gusmaoWilliam/FATECSO_PIC_ECU/README.md

# FATEC-Sorocaba-ECU-PIC-Verde
Desenvolvimento do gerenciamento do motor do carro didático VW Polo Flex utilizando um hardware desenvolvido por um grupo de alunos de Eletrônica Automotiva da Fatec Santo André.

Este repositório contém os firmwares atualizados dos PICs, software aplicativo deesenvolvido com o a plataforma QTCreator, e o firmware para arduino de um gerador de sinais de rotação e fase, cujas versoes foram as utilizadas na finalização do TCC "Sistema de aquisição de dados e calibração online aplicados à unidade de gerenciamento de um motor a combustão" apresentado pelos alunos William Miranda Gusmão e Lucas Wallace Martins.
