gusmaoWilliam/FATECSO_PIC_ECU/Hardware Placa Verde PIC/Lista de Componentes/Lista de componentes contidos na placa para a versão nova - Cópia.xls

Lista de Componentes Atualizada para nova versão da placa.
Resistores | Quantidade | Capacitores | Quantidade | Diodos | Quantidade | Transistores | Quantidade | Crystais | Quantidade | Cis | Quantidade | Outros | Quantidade
1M | 5 | 22pf | 10 | 1N4004 | 1 | IRGS14C40L | 4 | 10Mhz | 4 | TPIC8101 | 1 | Led | 21
10k | 76 | 100pf | 11 | 1N5624 | 2 | IRLL014N | 9 | 6Mhz | 1 | LM2596S | 1 | Indutor | 1
470R | 4 | 100uf/16v | 5 | 1N4148 | 20 |  |  | 20Mhz | 1 | AD623 | 2 | Trimpot 5k | 2
100k | 22 | 100nf | 90 |  |  |  |  |  |  | LM358D | 10 | MiniUSB | 1
1K | 31 | 680uF/35v | 1 |  |  |  |  |  |  | LM339 | 3 | Push button | 2
4k7 | 5 | 470uf/25v | 1 |  |  |  |  |  |  | MCP2515 | 1 | Chave Magirus | 1
5k6 | 11 | 1uf | 6 |  |  |  |  |  |  | PCA82C251T/N3 | 1 | Botoes SMD | 4
10R | 1 | 10pf | 2 |  |  |  |  |  |  | FT232RL | 1 | Pinos Torneados | 50
220R | 1 | 4u7f/16 | 1 |  |  |  |  |  |  | MC33186 | 1 | Jumper para Programação | 4
120R | 1 | 47uf/25v | 1 |  |  |  |  |  |  | MC33810 | 1 | Bournes | 4
100R | 2 | 33nf | 1 |  |  |  |  |  |  | LM1815 | 1
0R02 | 1 | 47nf | 1
4k | 4 | 330nf | 1
36k | 4 | 1nf | 1
3k6 | 1
18k | 1
150k | 1
