gusmaoWilliam/FATECSO_PIC_ECU/Hardware Placa Verde PIC/Lista de Componentes/Lista de componentes para 1 placa (v2).xls

Part | Value | Device | Package | Library | Sheet | Imagens dos componentes |  | Quantidade
+5V |  | LEDKA-3528ASYC | KA-3528ASYC | led | 2 |  |  | 21
+12V |  | LEDKA-3528ASYC | KA-3528ASYC | led | 2
BOB1 |  | LEDKA-3528ASYC | KA-3528ASYC | led | 14
BOB2 |  | LEDKA-3528ASYC | KA-3528ASYC | led | 14
TX |  | LEDKA-3528ASYC | KA-3528ASYC | led | 10
TXCAN |  | LEDKA-3528ASYC | KA-3528ASYC | led | 9
RX |  | LEDKA-3528ASYC | KA-3528ASYC | led | 10
RXCAN |  | LEDKA-3528ASYC | KA-3528ASYC | led | 9
IGN1 |  | LEDKA-3528ASYC | KA-3528ASYC | led | 15
IGN2 |  | LEDKA-3528ASYC | KA-3528ASYC | led | 15
IGN3 |  | LEDKA-3528ASYC | KA-3528ASYC | led | 15
IGN4 |  | LEDKA-3528ASYC | KA-3528ASYC | led | 15
INJ1 |  | LEDKA-3528ASYC | KA-3528ASYC | led | 15
INJ2 |  | LEDKA-3528ASYC | KA-3528ASYC | led | 15
INJ3 |  | LEDKA-3528ASYC | KA-3528ASYC | led | 15
INJ4 |  | LEDKA-3528ASYC | KA-3528ASYC | led | 15
LED1 |  | LEDKA-3528ASYC | KA-3528ASYC | led | 1
LED2 |  | LEDKA-3528ASYC | KA-3528ASYC | led | 8
LED3 |  | LEDKA-3528ASYC | KA-3528ASYC | led | 14
LED4 |  | LEDKA-3528ASYC | KA-3528ASYC | led | 17
LED16 |  | LEDKA-3528ASYC | KA-3528ASYC | led | 11
ANTER_IN | PINO_TORNEADO | PINO_TORNEADO | PINO_TORNEADO | MyLibs | 16 |  |  | 45
BORBOLETA_1 | PINO_TORNEADO | PINO_TORNEADO | PINO_TORNEADO | MyLibs | 12
BORBOLETA_2 | PINO_TORNEADO | PINO_TORNEADO | PINO_TORNEADO | MyLibs | 12
COND_ANA2_IN | PINO_TORNEADO | PINO_TORNEADO | PINO_TORNEADO | MyLibs | 6
COND_ANA_1_IN | PINO_TORNEADO | PINO_TORNEADO | PINO_TORNEADO | MyLibs | 6
LINHA15 | PINO_TORNEADO | PINO_TORNEADO | PINO_TORNEADO | MyLibs | 17
LINHA_15_IN | PINO_TORNEADO | PINO_TORNEADO | PINO_TORNEADO | MyLibs | 17
MAP_IN | PINO_TORNEADO | PINO_TORNEADO | PINO_TORNEADO | MyLibs | 16
MAP_OUT | PINO_TORNEADO | PINO_TORNEADO | PINO_TORNEADO | MyLibs | 16
MEDI_VELO_IN | PINO_TORNEADO | PINO_TORNEADO | PINO_TORNEADO | MyLibs | 17
MEDI_VELO_OUT | PINO_TORNEADO | PINO_TORNEADO | PINO_TORNEADO | MyLibs | 17
PEDAL1_IN | PINO_TORNEADO | PINO_TORNEADO | PINO_TORNEADO | MyLibs | 5
PEDAL2_IN | PINO_TORNEADO | PINO_TORNEADO | PINO_TORNEADO | MyLibs | 5
RA0_ADMISS_TPS_1 | PINO_TORNEADO | PINO_TORNEADO | PINO_TORNEADO | MyLibs | 13
RA0_GERENC_BATERIA | PINO_TORNEADO | PINO_TORNEADO | PINO_TORNEADO | MyLibs | 6
RA1_ADMISS_TPS_2 | PINO_TORNEADO | PINO_TORNEADO | PINO_TORNEADO | MyLibs | 13
RA1_GERENC_PEDAL_1 | PINO_TORNEADO | PINO_TORNEADO | PINO_TORNEADO | MyLibs | 5
RA2_ADMISS_ALTERNADOR | PINO_TORNEADO | PINO_TORNEADO | PINO_TORNEADO | MyLibs | 16
RA2_GERENC_PEDAL2 | PINO_TORNEADO | PINO_TORNEADO | PINO_TORNEADO | MyLibs | 5
RB5_GERENC_PRESS絨_A/C | PINO_TORNEADO | PINO_TORNEADO | PINO_TORNEADO | MyLibs | 6
RC7_GERENCIA_EMBREAGEM | PINO_TORNEADO | PINO_TORNEADO | PINO_TORNEADO | MyLibs | 7
RD2_GERENC_FREIO_1 | PINO_TORNEADO | PINO_TORNEADO | PINO_TORNEADO | MyLibs | 17
RD3_GERENCI_COMBUSTIVEL | PINO_TORNEADO | PINO_TORNEADO | PINO_TORNEADO | MyLibs | 7
RD5_GERENC_FREIO_2 | PINO_TORNEADO | PINO_TORNEADO | PINO_TORNEADO | MyLibs | 7
RD6_GERENC_BOTﾃO_A/C | PINO_TORNEADO | PINO_TORNEADO | PINO_TORNEADO | MyLibs | 7
RE2_SINCRO_FASE | PINO_TORNEADO | PINO_TORNEADO | PINO_TORNEADO | MyLibs | 17
RELUTﾂNCIA | PINO_TORNEADO | PINO_TORNEADO | PINO_TORNEADO | MyLibs | 18
ROT_ANAL | PINO_TORNEADO | PINO_TORNEADO | PINO_TORNEADO | MyLibs | 18
ROT_DIG_IN | PINO_TORNEADO | PINO_TORNEADO | PINO_TORNEADO | MyLibs | 18
ROT_DIG_OUT | PINO_TORNEADO | PINO_TORNEADO | PINO_TORNEADO | MyLibs | 18
SENSOR_COMB_IN | PINO_TORNEADO | PINO_TORNEADO | PINO_TORNEADO | MyLibs | 7
SENSOR_FASE_IN | PINO_TORNEADO | PINO_TORNEADO | PINO_TORNEADO | MyLibs | 17
SENSOR_IN | PINO_TORNEADO | PINO_TORNEADO | PINO_TORNEADO | MyLibs | 7
SENSOR_IN1 | PINO_TORNEADO | PINO_TORNEADO | PINO_TORNEADO | MyLibs | 17
SENSO_EMBR_IN | PINO_TORNEADO | PINO_TORNEADO | PINO_TORNEADO | MyLibs | 7
SENSO_FREIO_IN | PINO_TORNEADO | PINO_TORNEADO | PINO_TORNEADO | MyLibs | 7
TEMP_AR_IN | PINO_TORNEADO | PINO_TORNEADO | PINO_TORNEADO | MyLibs | 4
TEMP_AR_OUT | PINO_TORNEADO | PINO_TORNEADO | PINO_TORNEADO | MyLibs | 4
TEMP_H2O_IN | PINO_TORNEADO | PINO_TORNEADO | PINO_TORNEADO | MyLibs | 4
TEMP_H2O_OUT | PINO_TORNEADO | PINO_TORNEADO | PINO_TORNEADO | MyLibs | 4
TPS_1_IN | PINO_TORNEADO | PINO_TORNEADO | PINO_TORNEADO | MyLibs | 13
TPS_2_IN | PINO_TORNEADO | PINO_TORNEADO | PINO_TORNEADO | MyLibs | 13
SV1 |  | MA03-1 | MA03-1 | con-lstb | 1
SV2 |  | MA03-1 | MA03-1 | con-lstb | 14
OP.MODE |  | M251 | M251 | switch | 18
SENSIBILIDADE |  | M251 | M251 | switch | 18
SV3 |  | MA04-2 | MA04-2 | con-lstb | 18
C64 | 100uF/16V | CPOL-EUE2.5-7 | E2,5-7 | rcl | 2 |  |  | 5
C66 | 100uF/16V | CPOL-EUE2.5-7 | E2,5-7 | rcl | 1
C98 | 100uF/16V | CPOL-EUE2.5-7 | E2,5-7 | rcl | 8
C39 | 100uF/16V | CPOL-EUE2.5-7 | E2,5-7 | rcl | 14
C122 | 100uF/16V | CPOL-EUE2.5-7 | E2,5-7 | rcl | 11
C95 | 47uF/25V | CPOL-EUE2.5-7 | E2,5-7 | rcl | 12 |  |  | 1
C63 | 470uf/25V | CPOL-EUE3.5-8 | E3,5-8 | rcl | 2 |  |  | 1
C113 | 680uF/35V | CPOL-EUE3.5-10 | E3,5-10 | rcl | 2 |  |  | 1
C119 | 4u7F/16V | CPOL-EUE2.5-7 | E2,5-7 | rcl | 10 |  |  | 1
C1 | 100nF | C-EUC0805 | C0805 | resistor | 5 |  |  | 90
C2 | 100nF | C-EUC0805 | C0805 | resistor | 5
C3 | 100nF | C-EUC0805 | C0805 | resistor | 5
C4 | 100nF | C-EUC0805 | C0805 | resistor | 5
C5 | 100nF | C-EUC0805 | C0805 | resistor | 16
C6 | 100nF | C-EUC0805 | C0805 | resistor | 16
C7 | 100nF | C-EUC0805 | C0805 | resistor | 16
C8 | 100nF | C-EUC0805 | C0805 | resistor | 16
C9 | 100nF | C-EUC0805 | C0805 | resistor | 5
C10 | 100nF | C-EUC0805 | C0805 | resistor | 5
C11 | 100nF | C-EUC0805 | C0805 | resistor | 5
C12 | 100nF | C-EUC0805 | C0805 | resistor | 5
C13 | 100nF | C-EUC0805 | C0805 | resistor | 4
C14 | 100nF | C-EUC0805 | C0805 | resistor | 4
C15 | 100nF | C-EUC0805 | C0805 | resistor | 4
C16 | 100nF | C-EUC0805 | C0805 | resistor | 4
C17 | 100nF | C-EUC0805 | C0805 | resistor | 4
C18 | 100nF | C-EUC0805 | C0805 | resistor | 4
C19 | 100nF | C-EUC0805 | C0805 | resistor | 4
C20 | 100nF | C-EUC0805 | C0805 | resistor | 4
C25 | 100nF | C-EUC0805 | C0805 | resistor | 13
C26 | 100nF | C-EUC0805 | C0805 | resistor | 13
C27 | 100nF | C-EUC0805 | C0805 | resistor | 13
C28 | 100nF | C-EUC0805 | C0805 | resistor | 13
C29 | 100nF | C-EUC0805 | C0805 | resistor | 13
C30 | 100nF | C-EUC0805 | C0805 | resistor | 13
C31 | 100nF | C-EUC0805 | C0805 | resistor | 13
C32 | 100nF | C-EUC0805 | C0805 | resistor | 13
C36 | 100nF | C-EUC0805 | C0805 | resistor | 18
C37 | 100nF | C-EUC0805 | C0805 | resistor | 18
C40 | 100nF | C-EUC0805 | C0805 | resistor | 12
C41 | 100nF | C-EUC0805 | C0805 | resistor | 15
C42 | 100nF | C-EUC0805 | C0805 | resistor | 17
C43 | 100nF | C-EUC0805 | C0805 | resistor | 17
C44 | 100nF | C-EUC0805 | C0805 | resistor | 7
C45 | 100nF | C-EUC0805 | C0805 | resistor | 7
C46 | 100nF | C-EUC0805 | C0805 | resistor | 15
C47 | 100nF | C-EUC0805 | C0805 | resistor | 15
C48 | 100nF | C-EUC0805 | C0805 | resistor | 15
C49 | 100nF | C-EUC0805 | C0805 | resistor | 15
C50 | 100nF | C-EUC0805 | C0805 | resistor | 15
C54 | 100nF | C-EUC0805 | C0805 | resistor | 7
C55 | 100nF | C-EUC0805 | C0805 | resistor | 7
C56 | 100nF | C-EUC0805 | C0805 | resistor | 7
C57 | 100nF | C-EUC0805 | C0805 | resistor | 17
C58 | 100nF | C-EUC0805 | C0805 | resistor | 7
C59 | 100nF | C-EUC0805 | C0805 | resistor | 7
C60 | 100nF | C-EUC0805 | C0805 | resistor | 7
C61 | 100nF | C-EUC0805 | C0805 | resistor | 17
C62 | 100nF | C-EUC0805 | C0805 | resistor | 15
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
U$17 | IRLL014N | IRLL014N | SOT-223 | MyLibs | 19
U$1 | IRLL014N | IRLL014N | SOT-223 | MyLibs | 19
U$26 | IRLL014N | IRLL014N | SOT-223 | MyLibs | 19
U$27 | IRLL014N | IRLL014N | SOT-223 | MyLibs | 19
U$28 | IRLL014N | IRLL014N | SOT-223 | MyLibs | 19
U$29 | IRLL014N | IRLL014N | SOT-223 | MyLibs | 19
U$30 | IRLL014N | IRLL014N | SOT-223 | MyLibs | 19
U$4 | IRGS14C40L | IRGS14C40L | TO-263AB | MyLibs | 15
U$6 | IRGS14C40L | IRGS14C40L | TO-263AB | MyLibs | 15
U$7 | IRGS14C40L | IRGS14C40L | TO-263AB | MyLibs | 15
U$8 | IRGS14C40L | IRGS14C40L | TO-263AB | MyLibs | 15
S1 | 2P2T | 2P2T | 2P2T | switch | 17
S2 | 2P2T | 2P2T | 2P2T | switch | 16
U$15 | BUTTON | BUTTON | BUTTON_SMD | MyLibs | 8
U$18 | BUTTON | BUTTON | BUTTON_SMD | MyLibs | 1
U$20 | BUTTON | BUTTON | BUTTON_SMD | MyLibs | 11
U$21 | BUTTON | BUTTON | BUTTON_SMD | MyLibs | 14
X2 | MINI-USB-32005-201 | MINI-USB-32005-201 | 32005-201 | con-cypressindustri | es 10
U$5 | MAGIRUS_17105 | MAGIRUS_17105 | MAGIRUS_TICTAC_3_PIN | MyLibs | 2
U$11 | MAGIRUS_17105 | MAGIRUS_17105 | MAGIRUS_TICTAC_3_PIN | MyLibs | 2
L1 | 33uh-5A | L-USWE-TPC | POWER-CHOKE_WE-TPC | rcl | 2
X1 | 1751248 | 1751248 | 1751248 | con-phoenix-350 | 2
X3 | 1727036 | 1727036 | 1727036 | con-phoenix-3.81 | 7 |  | 4 pinos
X4 | 1727036 | 1727036 | 1727036 | con-phoenix-3.81 | 15
IGN_1 | 1727036 | 1727036 | 1727036 | con-phoenix-3.81 | 14
IC8 | LM2596S | LM2596S | TO263-5 | national-semiconduc | tor 2
IC12 | FT232RL | FT232RL | SSOP28 | ftdichip | 10
MC1 | MC33810 | MC33810 | SOIC_32_PIN | MyLibs | 15
PIN | CONCTOR_BOSCH | CONCTOR_BOSCH | V23542-A1280-B300 | MyLibs | 2
U$2 | LM1815 | LM1815 | SOICLM1815 | MyLibs | 18
U$3 | MC33186 | MC33186 | HSOP-20-PIN | MyLibs | 12
U$9 | AD623 | AD623 | SOIC-8 | MyLibs | 3
U$10 | AD623 | AD623 | SOIC-8 | MyLibs | 3
U$19 | JHD162A | JHD162A | JHD162A | MyLibs | 8
U$22 | TPIC8101 | TPIC8101 | SOIC-20P | MyLibs | 2
U$31 | MCP2515-I/SO | MCP2515-I/SO | SOIC127P1034X264-18N | Microchip_By_elemen | t14_Batch_1 9
U$32 | TRIMPOT | TRIMPOT | TRIMPOT | MyLibs | 8
U$33 | HC-06 | HC-06 | FE06 | MyLibs | 10
U1 | LM339 | LM339 | SOIC14N | MyLibs | 17
U2 | LM339 | LM339 | SOIC14N | MyLibs | 7
U3 | LM339 | LM339 | SOIC14N | MyLibs | 17
U20 | PCA82C251T/N3 | PCA82C251T/N3 | SOIC127P600X175-8N | NXP_By_element14_Ba | tch_1 9
SINCRONISMO | PIC18F46K22 | PIC18F46K22 | DIP40 | MyLibs | 14
GERENCIAMENTO | PIC18F46K22 | PIC18F46K22 | DIP40 | MyLibs | 1
ADMISSﾃO | PIC18F46K22 | PIC18F46K22 | DIP40 | MyLibs | 11
COMUNICACAO | PIC18F46K22 | PIC18F46K22 | DIP40 | MyLibs | 8
