gusmaoWilliam/FATECSO_PIC_ECU/Apresentação Aquisiçao e Calibração/Apresentação_Calibração_Aquisição.pptx

## Núcleo de Pesquisa em Powertrain

AQUISIÇÃO DE DADOS E CALIBRAÇÃO ONLINE DA ECU PIC

## Comunicação Assincrona

- BAUDRATE

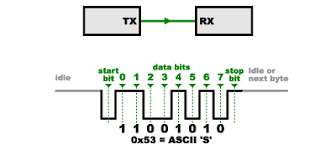
[picture p1: figure]

## Protocolo UART

- UART é o acrônimo de Universal Asynchrounous Receiver/Transmiter ou Receptor/Transmissor Universal Assíncrono.

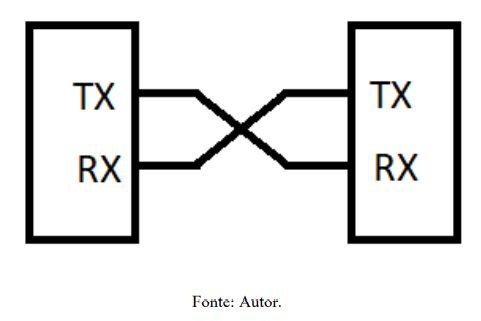
[picture p2: figure]

## Protocolo UART

- FRAME:
- Start bit: S
- Stop bit: T
- Bit de paridade: P
- Dados: 01234567

## Firmware Comunicação

- O PIC responsável pela comunicação tem por objetivo estabelecer o fornecimento de dados para os demais PIC’s, e torna possível o envio para um protocolo de comunicação USB, em que permite se conectar a um computador para que sejam coletados os dados dos sensores pela interface de aquisição e calibração desenvolvida.

## Firmware Comunicação

- Interrupção

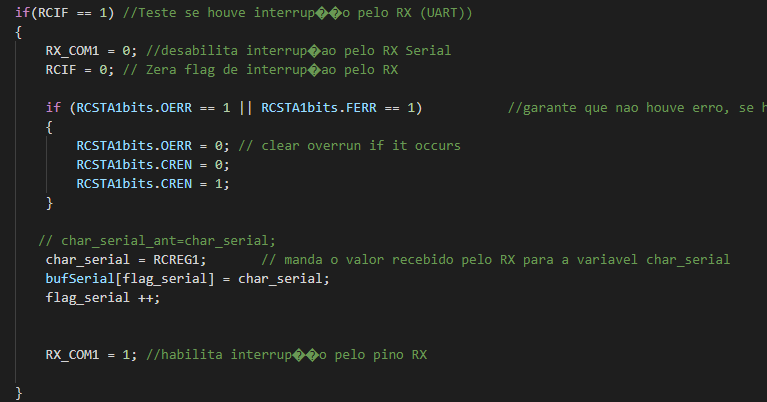
[picture p3: figure]

## Firmware Comunicação

- Interrupção

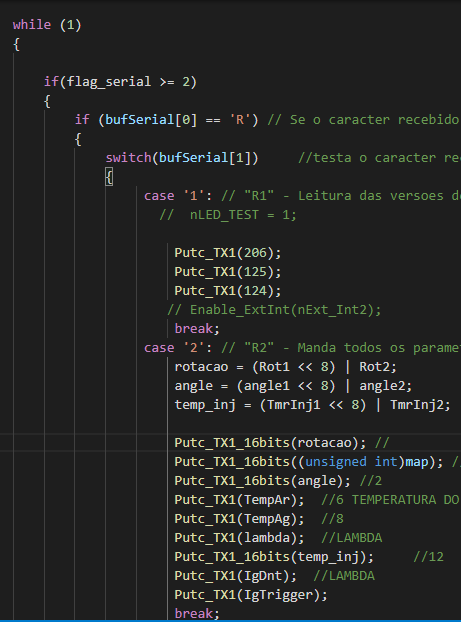
[picture p4: figure]
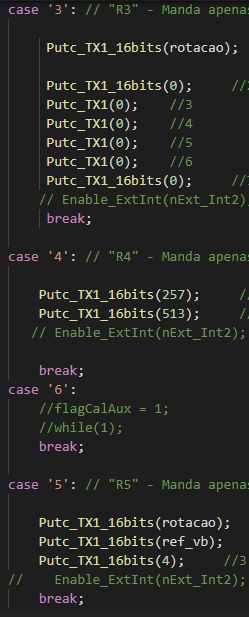
[picture p5: figure]
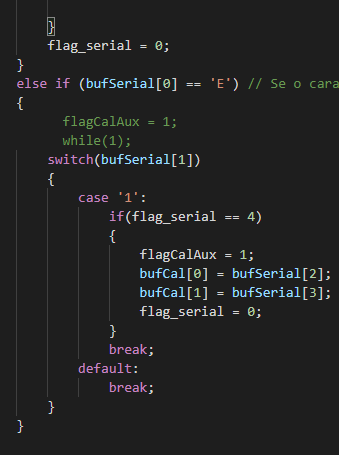
[picture p6: figure]

## QT Creator

Para que fosse possível realizar a aquisição dos dados do motor, e calibração de parâmetros, foi necessário desenvolver uma interface visual, que pudesse comunicar-se via serial com a ECU.

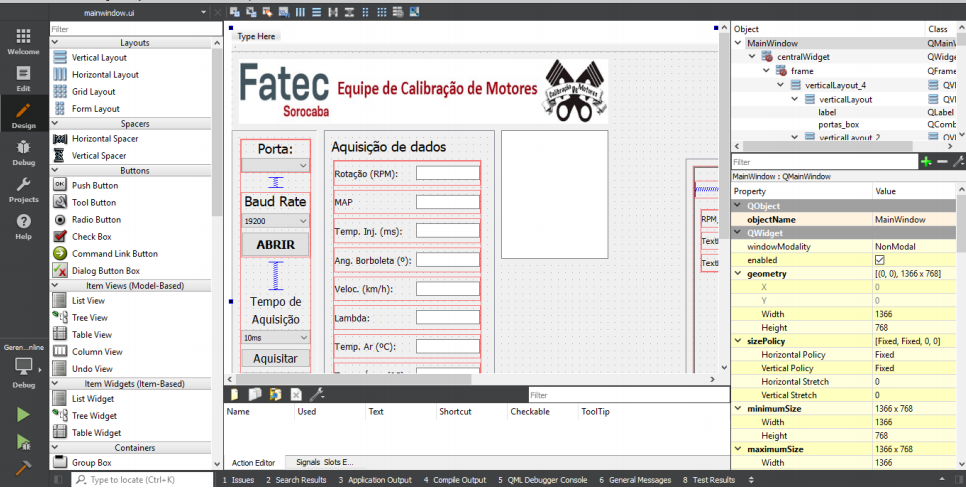
[picture p7: figure]

## QT Creator

- Interface desenvolvida :

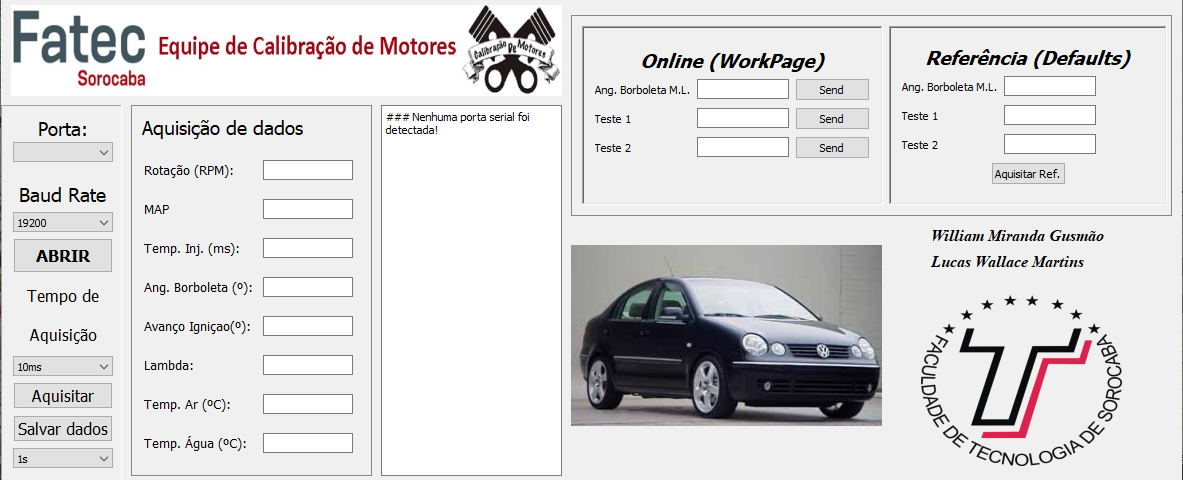
[picture p8: figure]

## Aquisição de dados

Estabelecido a comunicação, pode-se configurar o intervalo de tempo entre as aquisições.
Após pressionar o botão “Aquisitar”, a interface enviará com um intervalo de tempo definido acima o caractere “R” seguido do caractere “2” via serial. Com isso, o PIC de Comunicação identificará pelo comando que está sendo requisitado os dados citados acima, e então, enviará esses dados para a interface.
É possível ainda, salvar esses dados em uma planilha do Excel, basta definir o tempo o tempo de aquisição e clicar em “Salvar Dados”.

## Software Aplicativo: Aquisiçao

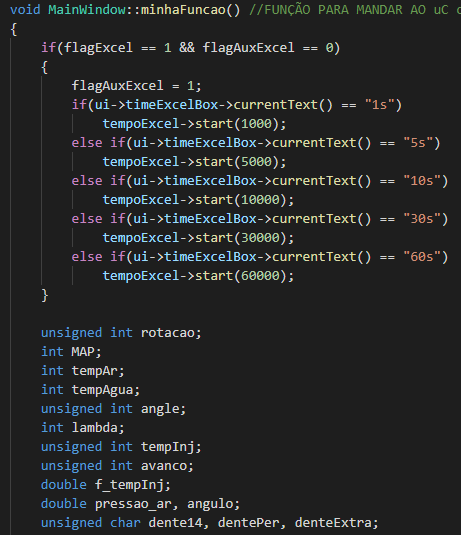
[picture p9: figure]
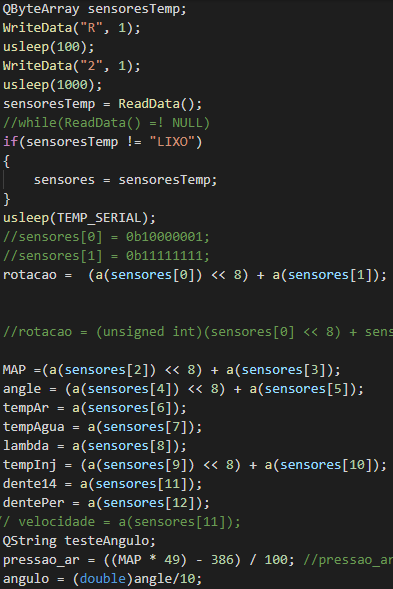
[picture p10: figure]
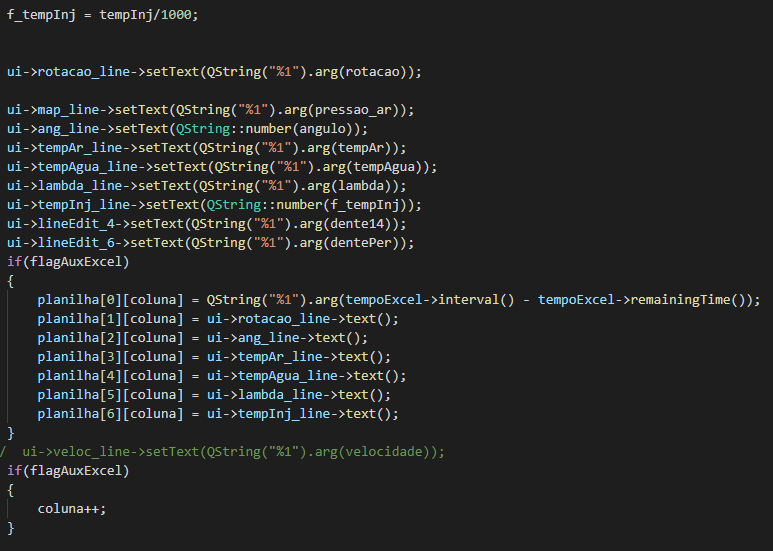
[picture p11: figure]

## Software Aplicativo: Salvar dados

- Para salvar os dados em uma
- tabela no Excel, foi definido as
- colunas para cada variável, e de
- acordo com o numero de
- amostragem será definido a
- quantidade de linhas.

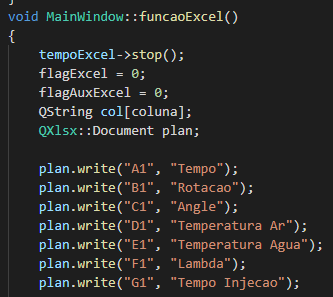
[picture p12: figure]
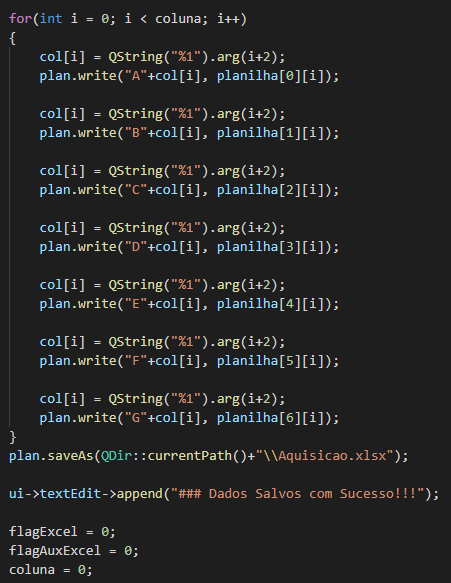
[picture p13: figure]

## Software Aplicativo: Calibração

- O software aplicativo primeiramente irá enviar para a ECU o caractere “E” seguido do caractere “1”, e então enviará o valor inserido pelo usuário, que será tratado logo em seguida pelos microcontroladores do módulo.

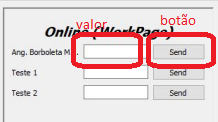
[picture p14: figure]
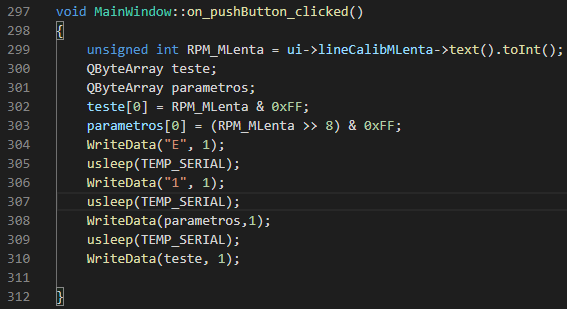
[picture p15: figure]

## Software Aplicativo: Defaults

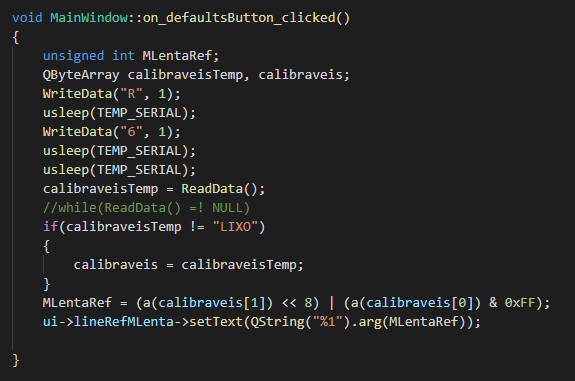
[picture p16: figure]

## Ferramenta similar usada na indústria

- ETAS INCA

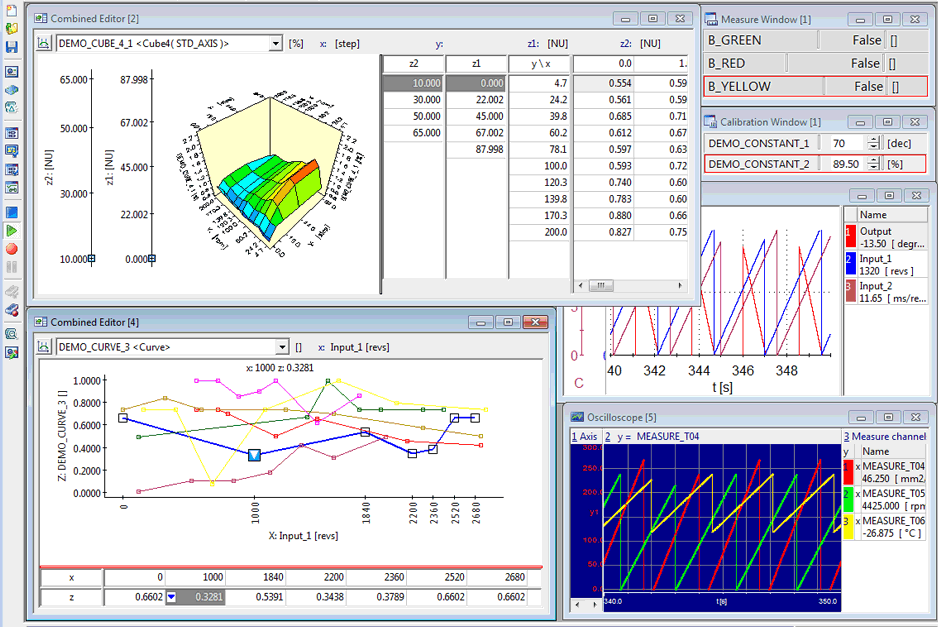
[picture p17: figure]

## Simulações: Arduino

- Uma maneira de facilitar este processo foi desenvolver um gerador de sinais de rotação e fase, que foi suficiente para o desenvolvimento da comunicação entre os dispositivos.

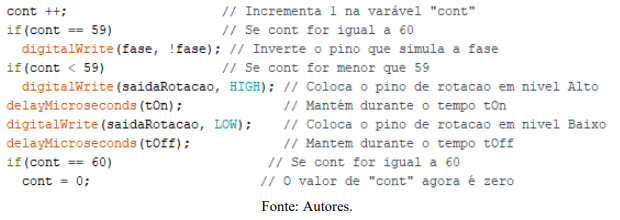
[picture p18: figure]
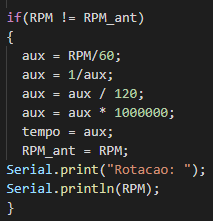
[picture p19: figure]

## Nova interface

- Proposta de melhoria, aprimorar a aquisição, calibração, novo design.

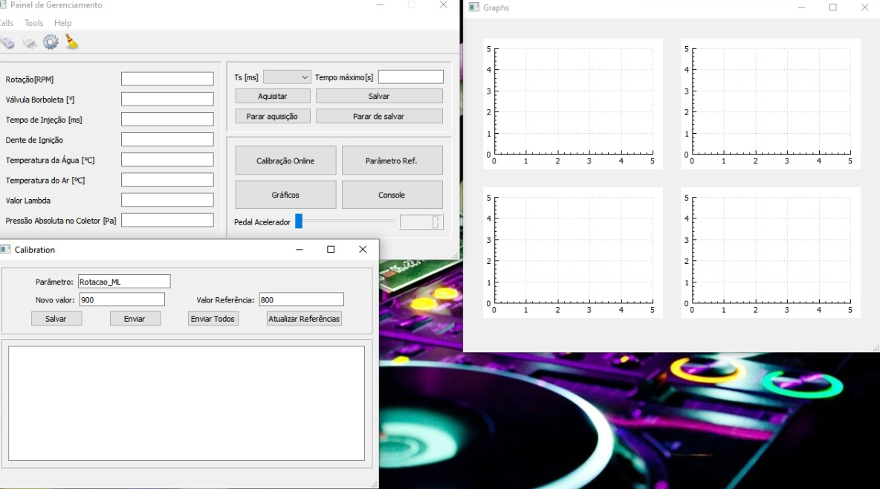
[picture p20: figure]

## NÚCLEO DE PESQUISA EM POWERTRAIN

- Obrigado!

- William Miranda Gusmão
- Lucas Wallace Martins da Silva
- n.p.powertrain@gmail.com
