gusmaoWilliam/FATECSO_PIC_ECU/(list of files, drawings)

Other design files:
Firmwares Antigos/REV03 (VERSAO I2C)/Comunicação_46K22.X/COM.pdsprj
Firmwares Calibracao Online/Comunicação_46K22.X/COM.pdsprj
