gusmaoWilliam/FATECSO_PIC_ECU/Hardware Placa Verde PIC/layout/ECU_MULT_CAR.brd

## EAGLE design Hardware Placa Verde PIC/layout/ECU_MULT_CAR.brd (2021-12-23)

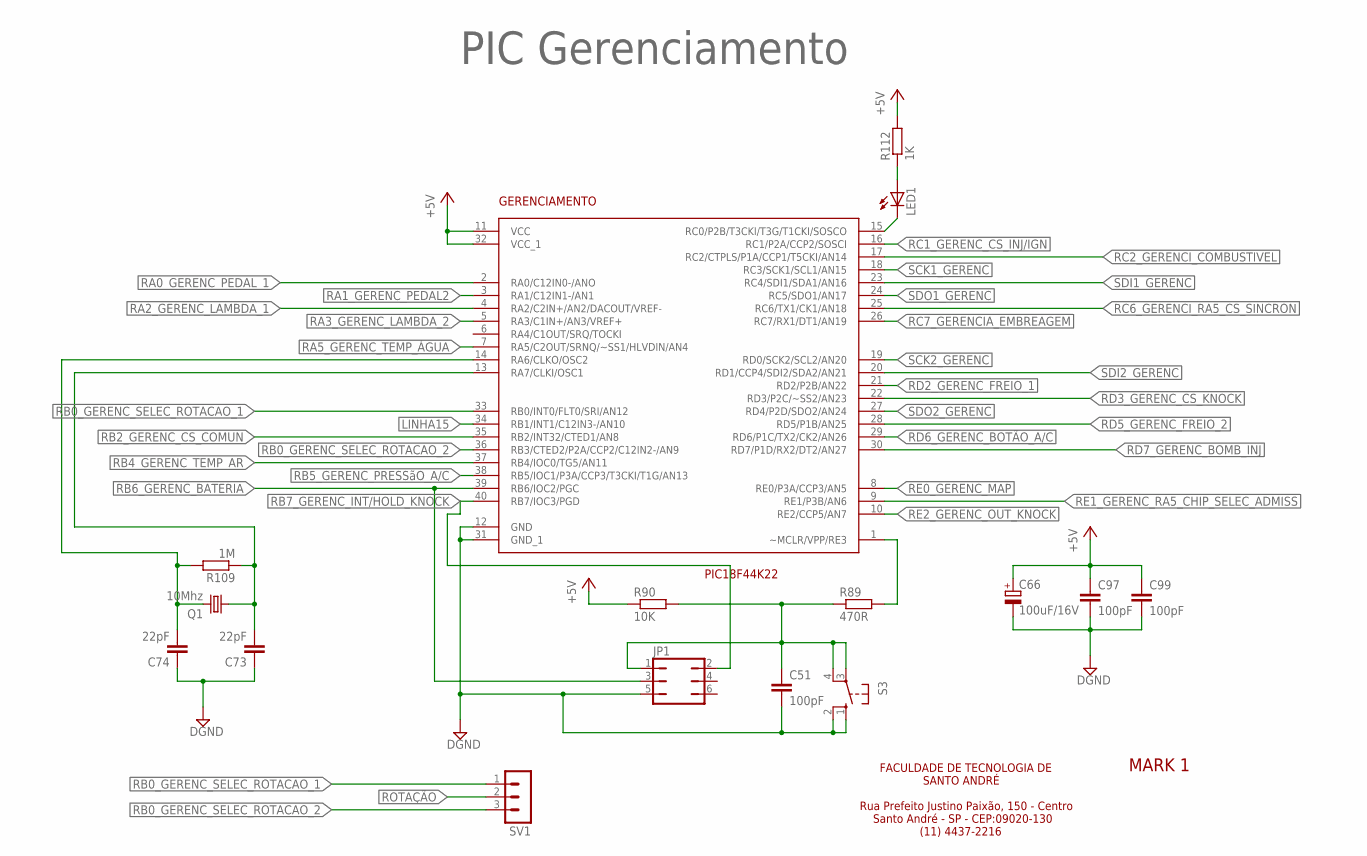
[picture p21: schematic ECU_MULT_CAR.sch, sheet 1]

Parts:
C51, C97, C99: 100pF; C0805
C66: 100uF/16V; E2,5-7
C73, C74: 22pF; C0805
GERENCIAMENTO: PIC18F44K22; DIP40
JP1: JP3Q
LED1: LEDKA-3528ASYC; KA-3528ASYC
Q1: 10Mhz; SM49
R89: 470R; M0805
R90: 10K; M0805
R109: 1M; M0805
R112: 1K; M0805
S3: 10-XX; B3F-10XX
SV1: MA03-1

Connections:
+5V: C66.+, C97.1, C99.1, GERENCIAMENTO.11 (VCC), GERENCIAMENTO.32 (VCC_1), R90.1, R112.2; also elsewhere on the board
DGND: C51.2, C66.-, C73.1, C74.1, C97.2, C99.2, GERENCIAMENTO.12 (GND), GERENCIAMENTO.31 (GND_1), JP1.5, S3.1 (S), S3.2 (S1); also elsewhere on the board
LINHA15: GERENCIAMENTO.34 (RB1/INT1/C12IN3-/AN10); also elsewhere on the board
unnamed: C73.2, GERENCIAMENTO.13 (RA7/CLKI/OSC1), Q1.1, R109.1
unnamed: GERENCIAMENTO.1 (~MCLR/VPP/RE3), R89.2
unnamed: C51.1, JP1.1, R89.1, R90.2, S3.3, S3.4 (P1)
unnamed: GERENCIAMENTO.15 (RC0/P2B/T3CKI/T3G/T1CKI/SOSCO), LED1.C
unnamed: LED1.A, R112.1
unnamed: C74.2, GERENCIAMENTO.14 (RA6/CLKO/OSC2), Q1.2, R109.2
RA0_GERENC_PEDAL_1: GERENCIAMENTO.2 (RA0/C12IN0-/ANO); also elsewhere on the board
RA1_GERENC_PEDAL2: GERENCIAMENTO.3 (RA1/C12IN1-/AN1); also elsewhere on the board
RA2_GERENC_LAMBDA_1: GERENCIAMENTO.4 (RA2/C2IN+/AN2/DACOUT/VREF-); also elsewhere on the board
RA3_GERENC_LAMBDA_2: GERENCIAMENTO.5 (RA3/C1IN+/AN3/VREF+); also elsewhere on the board
RA5_GERENC_TEMP_ÁGUA: GERENCIAMENTO.7 (RA5/C2OUT/SRNQ/~SS1/HLVDIN/AN4); also elsewhere on the board
RB0_GERENC_SELEC_ROTACAO_1: GERENCIAMENTO.33 (RB0/INT0/FLT0/SRI/AN12), SV1.1
RB0_GERENC_SELEC_ROTACAO_2: GERENCIAMENTO.36 (RB3/CTED2/P2A/CCP2/C12IN2-/AN9), SV1.3
RB2_GERENC_CS_COMUN: GERENCIAMENTO.35 (RB2/INT32/CTED1/AN8); also elsewhere on the board
RB4_GERENC_TEMP_AR: GERENCIAMENTO.37 (RB4/IOC0/TG5/AN11); also elsewhere on the board
RB5_GERENC_PRESSãO_A/C: GERENCIAMENTO.38 (RB5/IOC1/P3A/CCP3/T3CKI/T1G/AN13); also elsewhere on the board
RB6_GERENC_BATERIA: GERENCIAMENTO.39 (RB6/IOC2/PGC), JP1.3; also elsewhere on the board
RB7_GERENC_INT/HOLD_KNOCK: GERENCIAMENTO.40 (RB7/IOC3/PGD), JP1.2; also elsewhere on the board
RC1_GERENC_CS_INJ/IGN: GERENCIAMENTO.16 (RC1/P2A/CCP2/SOSCI); also elsewhere on the board
RC2_GERENCI_COMBUSTIVEL: GERENCIAMENTO.17 (RC2/CTPLS/P1A/CCP1/T5CKI/AN14); also elsewhere on the board
RC6_GERENCI_RA5_CS_SINCRON: GERENCIAMENTO.25 (RC6/TX1/CK1/AN18); also elsewhere on the board
RC7_GERENCIA_EMBREAGEM: GERENCIAMENTO.26 (RC7/RX1/DT1/AN19); also elsewhere on the board
RD2_GERENC_FREIO_1: GERENCIAMENTO.21 (RD2/P2B/AN22); also elsewhere on the board
RD3_GERENC_CS_KNOCK: GERENCIAMENTO.22 (RD3/P2C/~SS2/AN23); also elsewhere on the board
RD5_GERENC_FREIO_2: GERENCIAMENTO.28 (RD5/P1B/AN25); also elsewhere on the board
RD6_GERENC_BOTÃO_A/C: GERENCIAMENTO.29 (RD6/P1C/TX2/CK2/AN26); also elsewhere on the board
RD7_GERENC_BOMB_INJ: GERENCIAMENTO.30 (RD7/P1D/RX2/DT2/AN27); also elsewhere on the board
RE0_GERENC_MAP: GERENCIAMENTO.8 (RE0/P3A/CCP3/AN5); also elsewhere on the board
RE1_GERENC_RA5_CHIP_SELEC_ADMISS: GERENCIAMENTO.9 (RE1/P3B/AN6); also elsewhere on the board
RE2_GERENC_OUT_KNOCK: GERENCIAMENTO.10 (RE2/CCP5/AN7); also elsewhere on the board
ROTAÇÃO: SV1.2; also elsewhere on the board
SCK1_GERENC: GERENCIAMENTO.18 (RC3/SCK1/SCL1/AN15); also elsewhere on the board
SCK2_GERENC: GERENCIAMENTO.19 (RD0/SCK2/SCL2/AN20); also elsewhere on the board
SDI1_GERENC: GERENCIAMENTO.23 (RC4/SDI1/SDA1/AN16); also elsewhere on the board
SDI2_GERENC: GERENCIAMENTO.20 (RD1/CCP4/SDI2/SDA2/AN21); also elsewhere on the board
SDO1_GERENC: GERENCIAMENTO.24 (RC5/SDO1/AN17); also elsewhere on the board
SDO2_GERENC: GERENCIAMENTO.27 (RD4/P2D/SDO2/AN24); also elsewhere on the board

Notes on the sheet:
PIC Gerenciamento
FACULDADE DE TECNOLOGIA DE SANTO ANDRÉ Rua Prefeito Justino Paixão, 150 - Centro Santo André - SP - CEP:09020-130 (11) 4437-2216
MARK 1

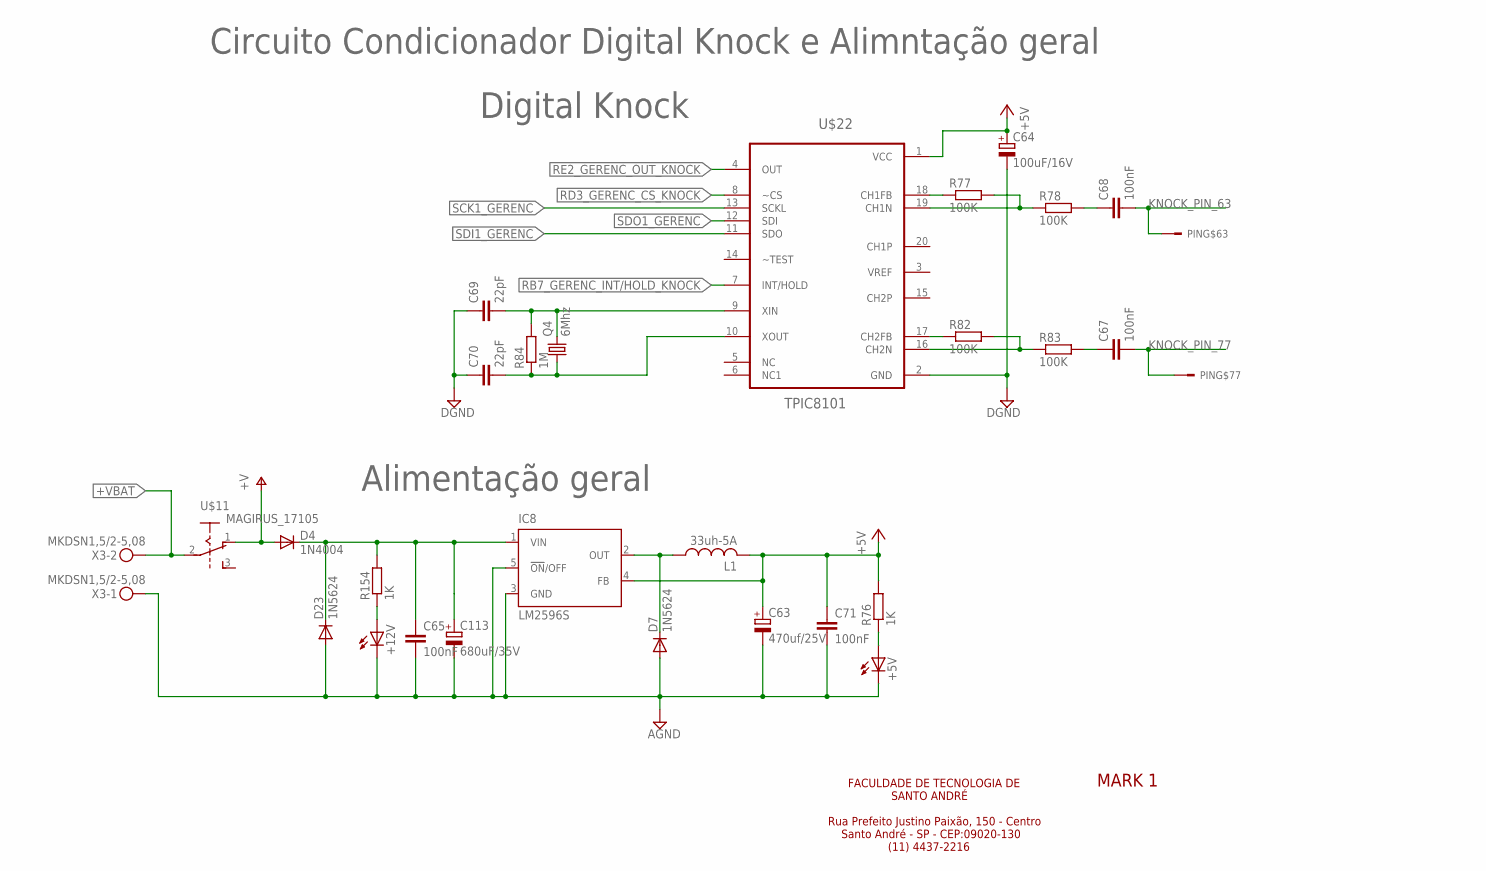
[picture p22: schematic ECU_MULT_CAR.sch, sheet 2]

Parts:
+5V, +12V: LEDKA-3528ASYC; KA-3528ASYC
C63: 470uf/25V; E3,5-8
C64: 100uF/16V; E2,5-7
C65, C67, C68, C71: 100nF; C0805
C69, C70: 22pF; C0805
C113: 680uF/35V; E3,5-10
D4: 1N4004; DO41-10
D7, D23: 1N5624; DO201-15
IC8: LM2596S; TO263-5
L1: 33uh-5A; POWER-CHOKE_WE-TPC
PIN: CONCTOR_BOSCH; V23542-A1280-B300
Q4: 6Mhz; SM49
R76, R154: 1K; M0805
R77, R78, R82, R83: 100K; M0805
R84: 1M; M0805
U$11: MAGIRUS_17105; MAGIRUS_TICTAC_3_PIN
U$22: TPIC8101; SOIC-20P
X3: MKDSN1,5/2-5,08

Connections:
+5V: C63.+, C64.+, C71.1, IC8.4 (FB), L1.2, R76.2, U$22.1 (VCC); also elsewhere on the board
+VBAT: U$11.2, X3.2; also elsewhere on the board
DGND: C64.-, C69.1, C70.1, U$22.2 (GND); also elsewhere on the board
GND3: +5V.C, +12V.C, C63.-, C65.2, C71.2, C113.-, D7.A, D23.A, IC8.3 (GND), IC8.5 (!ON!/OFF), X3.1; also elsewhere on the board
KNOCK_PIN_63: C68.2, PIN.63
KNOCK_PIN_77: C67.2, PIN.77
unnamed: R82.1, U$22.17 (CH2FB)
unnamed: +12V.A, R154.1
unnamed: C65.1, C113.+, D4.C, D23.C, IC8.1 (VIN), R154.2
unnamed: D7.C, IC8.2 (OUT), L1.1
unnamed: R77.1, U$22.18 (CH1FB)
unnamed: R77.2, R78.1, U$22.19 (CH1N)
unnamed: +5V.A, R76.1
unnamed: C68.1, R78.2
unnamed: R82.2, R83.1, U$22.16 (CH2N)
unnamed: C67.1, R83.2
unnamed: C70.2, Q4.1, R84.1, U$22.10 (XOUT)
unnamed: C69.2, Q4.2, R84.2, U$22.9 (XIN)
RB7_GERENC_INT/HOLD_KNOCK: U$22.7 (INT/HOLD); also elsewhere on the board
RD3_GERENC_CS_KNOCK: U$22.8 (~CS); also elsewhere on the board
RE2_GERENC_OUT_KNOCK: U$22.4 (OUT); also elsewhere on the board
SCK1_GERENC: U$22.13 (SCKL); also elsewhere on the board
SDI1_GERENC: U$22.11 (SDO); also elsewhere on the board
SDO1_GERENC: U$22.12 (SDI); also elsewhere on the board
V+: D4.A, U$11.1; also elsewhere on the board

Notes on the sheet:
Digital Knock
Alimentação geral
Circuito Condicionador Digital Knock e Alimntação geral
FACULDADE DE TECNOLOGIA DE SANTO ANDRÉ Rua Prefeito Justino Paixão, 150 - Centro Santo André - SP - CEP:09020-130 (11) 4437-2216
MARK 1

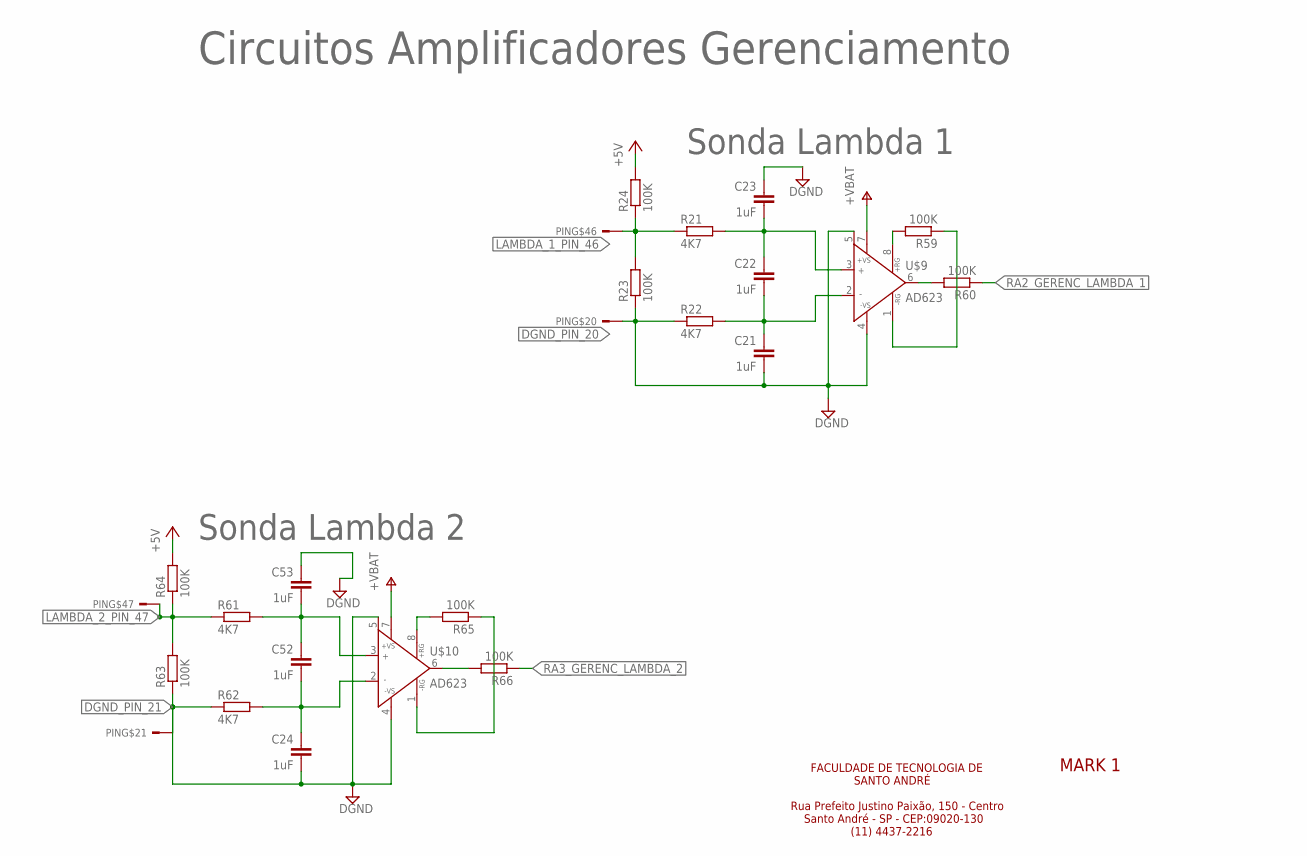
[picture p23: schematic ECU_MULT_CAR.sch, sheet 3]

Parts:
C21, C22, C23, C24, C52, C53: 1uF; C0805
PIN: CONCTOR_BOSCH; V23542-A1280-B300
R21, R22, R61, R62: 4K7; M0805
R23, R24, R59, R60, R63, R64, R65, R66: 100K; M0805
U$9, U$10: AD623; SOIC-8

Connections:
+5V: R24.2, R64.2; also elsewhere on the board
DGND: C23.1, C53.1; also elsewhere on the board
DGND_PIN_20: C21.2, PIN.20, R22.1, R23.1, U$9.4 (-VS), U$9.5 (REF)
DGND_PIN_21: C24.2, PIN.21, R62.1, R63.1, U$10.4 (-VS), U$10.5 (REF)
LAMBDA_1_PIN_46: PIN.46, R21.1, R23.2, R24.1
LAMBDA_2_PIN_47: PIN.47, R61.1, R63.2, R64.1
unnamed: C22.1, C23.2, R21.2, U$9.3 (+IN)
unnamed: C21.1, C22.2, R22.2, U$9.2 (-IN)
unnamed: C52.1, C53.2, R61.2, U$10.3 (+IN)
unnamed: C24.1, C52.2, R62.2, U$10.2 (-IN)
unnamed: R59.2, U$9.8 (+RG)
unnamed: R59.1, U$9.1 (-RG)
unnamed: R60.2, U$9.6 (OUTPUT)
unnamed: R65.2, U$10.8 (+RG)
unnamed: R65.1, U$10.1 (-RG)
unnamed: R66.2, U$10.6 (OUTPUT)
RA2_GERENC_LAMBDA_1: R60.1; also elsewhere on the board
RA3_GERENC_LAMBDA_2: R66.1; also elsewhere on the board
V+: U$9.7 (+VS), U$10.7 (+VS); also elsewhere on the board

Notes on the sheet:
Sonda Lambda 1
Sonda Lambda 2
Circuitos Amplificadores Gerenciamento
FACULDADE DE TECNOLOGIA DE SANTO ANDRÉ Rua Prefeito Justino Paixão, 150 - Centro Santo André - SP - CEP:09020-130 (11) 4437-2216
MARK 1

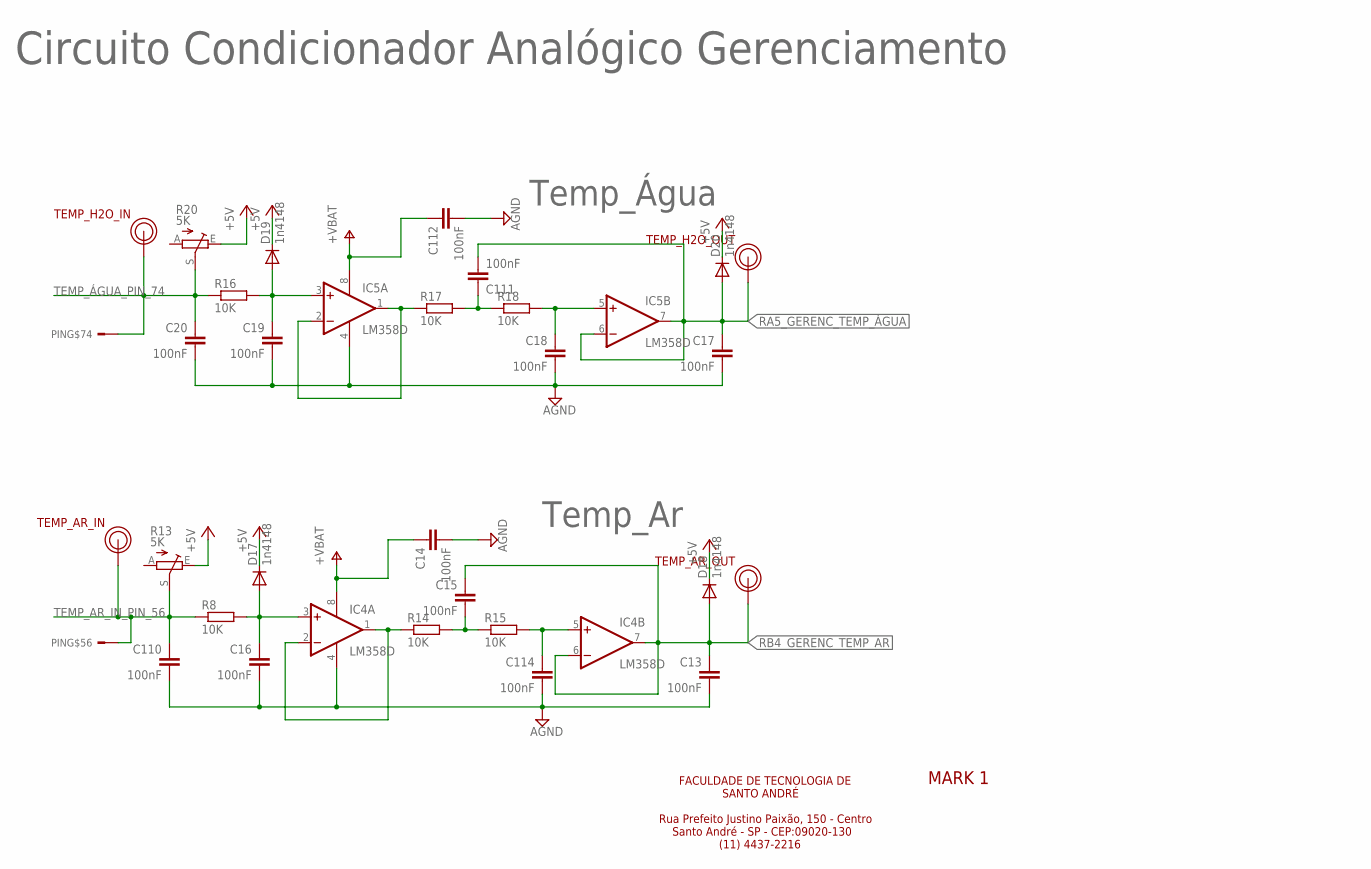
[picture p24: schematic ECU_MULT_CAR.sch, sheet 4]

Parts:
C13, C14, C15, C16, C17, C18, C19, C20, C110, C111, C112, C114: 100nF; C0805
D17, D18, D19, D20: 1n4148; MINIMELF
IC4, IC5: LM358D; SO08
PIN: CONCTOR_BOSCH; V23542-A1280-B300
R8, R14, R15, R16, R17, R18: 10K; M0805
R13, R20: 5K; S63P
TEMP_AR_IN: PINO_TORNEADO
TEMP_AR_OUT: PINO_TORNEADO
TEMP_H2O_IN, TEMP_H2O_OUT: PINO_TORNEADO

Connections:
+5V: D17.C, D18.C, D19.C, D20.C, R13.E, R20.E; also elsewhere on the board
GND3: C13.2, C14.2, C16.2, C17.2, C18.2, C19.2, C20.2, C110.2, C112.2, C114.2, IC4.4 (V-), IC5.4 (V-); also elsewhere on the board
unnamed: C16.1, D17.A, IC4.3 (+IN), R8.2
unnamed: C19.1, D19.A, IC5.3 (+IN), R16.2
unnamed: IC4.1 (OUT), IC4.2 (-IN), R14.1
unnamed: C15.2, R14.2, R15.1
unnamed: C114.1, IC4.5 (+IN), R15.2
unnamed: IC5.1 (OUT), IC5.2 (-IN), R17.1
unnamed: C111.1, R17.2, R18.1
unnamed: C18.1, IC5.5 (+IN), R18.2
RA5_GERENC_TEMP_ÁGUA: C17.1, C111.2, D20.A, IC5.6 (-IN), IC5.7 (OUT), TEMP_H2O_OUT.1; also elsewhere on the board
RB4_GERENC_TEMP_AR: C13.1, C15.1, D18.A, IC4.6 (-IN), IC4.7 (OUT), TEMP_AR_OUT.1; also elsewhere on the board
TEMP_AR_IN_PIN_56: C110.1, PIN.56, R8.1, R13.S, TEMP_AR_IN.1
TEMP_ÁGUA_PIN_74: C20.1, PIN.74, R16.1, R20.S, TEMP_H2O_IN.1
V+: C14.1, C112.1, IC4.8 (V+), IC5.8 (V+); also elsewhere on the board

Notes on the sheet:
Temp_Ar
Temp_Água
Circuito Condicionador Analógico Gerenciamento
FACULDADE DE TECNOLOGIA DE SANTO ANDRÉ Rua Prefeito Justino Paixão, 150 - Centro Santo André - SP - CEP:09020-130 (11) 4437-2216
MARK 1

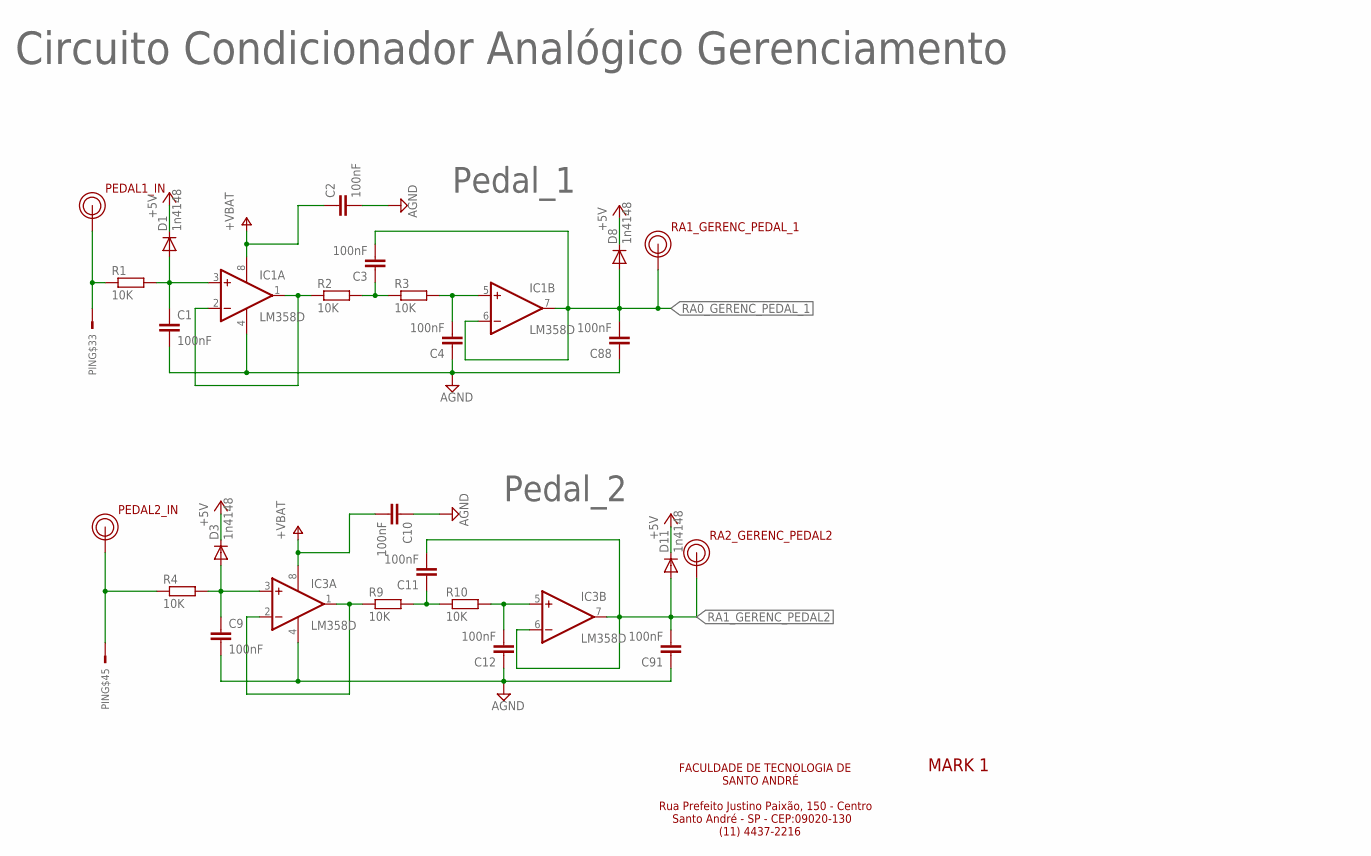
[picture p25: schematic ECU_MULT_CAR.sch, sheet 5]

Parts:
C1, C2, C3, C4, C9, C10, C11, C12, C88, C91: 100nF; C0805
D1, D3, D8, D11: 1n4148; MINIMELF
IC1, IC3: LM358D; SO08
PEDAL1_IN, PEDAL2_IN: PINO_TORNEADO
PIN: CONCTOR_BOSCH; V23542-A1280-B300
R1, R2, R3, R4, R9, R10: 10K; M0805
RA1_GERENC_PEDAL_1, RA2_GERENC_PEDAL2: PINO_TORNEADO

Connections:
+5V: D1.C, D3.C, D8.C, D11.C; also elsewhere on the board
GND3: C1.2, C2.2, C4.1, C9.2, C10.1, C12.1, C88.1, C91.1, IC1.4 (V-), IC3.4 (V-); also elsewhere on the board
unnamed: C1.1, D1.A, IC1.3 (+IN), R1.2
unnamed: IC1.1 (OUT), IC1.2 (-IN), R2.1
unnamed: C9.1, D3.A, IC3.3 (+IN), R4.2
unnamed: C3.1, R2.2, R3.1
unnamed: C4.2, IC1.5 (+IN), R3.2
unnamed: IC3.1 (OUT), IC3.2 (-IN), R9.1
unnamed: C11.1, R9.2, R10.1
unnamed: C12.2, IC3.5 (+IN), R10.2
PEDAL1_PIN_33: PEDAL1_IN.1, PIN.33, R1.1
PEDAL2_PIN_45: PEDAL2_IN.1, PIN.45, R4.1
RA0_GERENC_PEDAL_1: C3.2, C88.2, D8.A, IC1.6 (-IN), IC1.7 (OUT), RA1_GERENC_PEDAL_1.1; also elsewhere on the board
RA1_GERENC_PEDAL2: C11.2, C91.2, D11.A, IC3.6 (-IN), IC3.7 (OUT), RA2_GERENC_PEDAL2.1; also elsewhere on the board
V+: C2.1, C10.2, IC1.8 (V+), IC3.8 (V+); also elsewhere on the board

Notes on the sheet:
Pedal_1
Pedal_2
Circuito Condicionador Analógico Gerenciamento
FACULDADE DE TECNOLOGIA DE SANTO ANDRÉ Rua Prefeito Justino Paixão, 150 - Centro Santo André - SP - CEP:09020-130 (11) 4437-2216
MARK 1

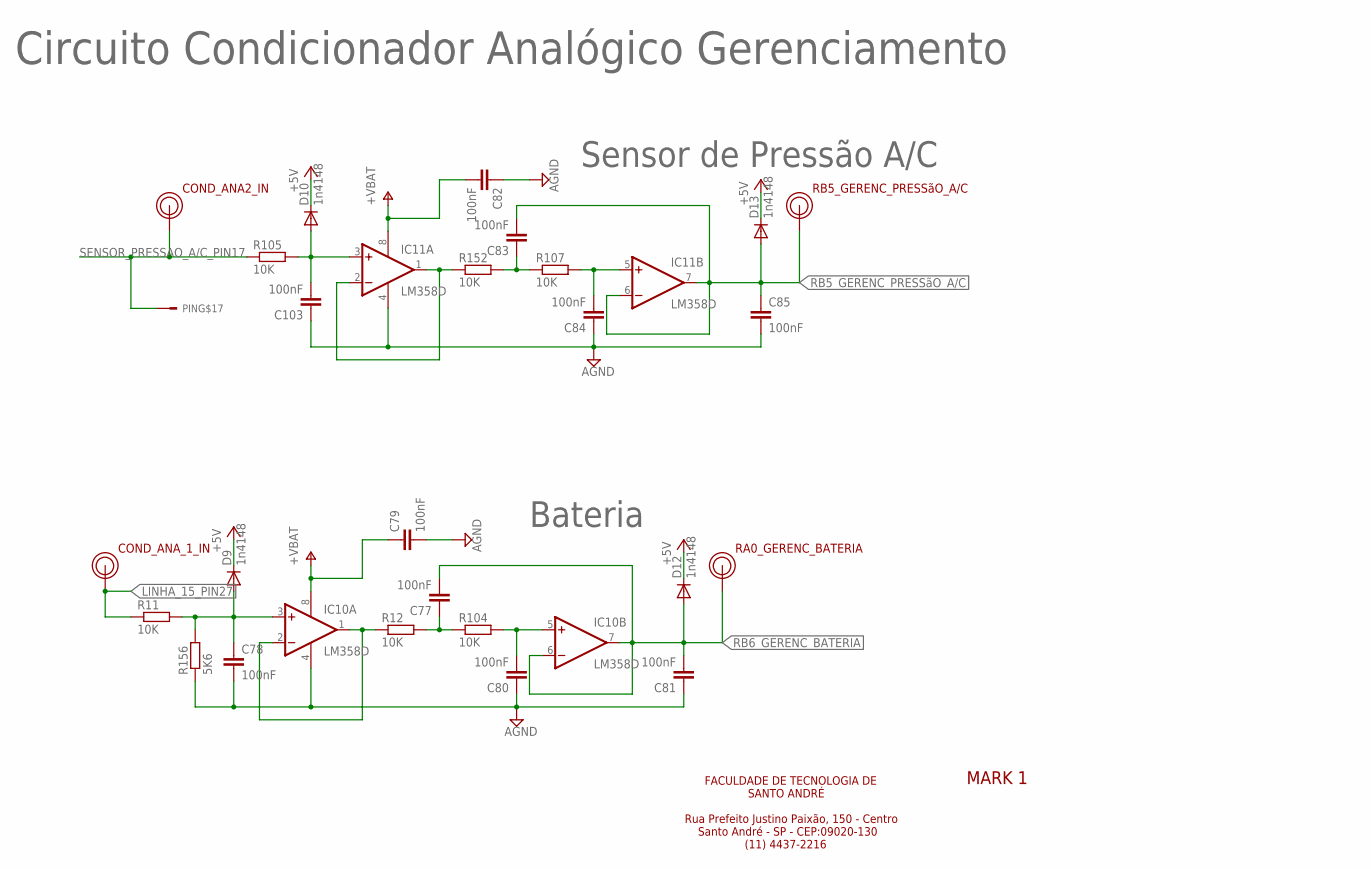
[picture p26: schematic ECU_MULT_CAR.sch, sheet 6]

Parts:
C77, C78, C79, C80, C81, C82, C83, C84, C85, C103: 100nF; C0805
COND_ANA2_IN: PINO_TORNEADO
COND_ANA_1_IN: PINO_TORNEADO
D9, D10, D12, D13: 1n4148; MINIMELF
IC10, IC11: LM358D; SO08
PIN: CONCTOR_BOSCH; V23542-A1280-B300
R11, R12, R104, R105, R107, R152: 10K; M0805
R156: 5K6; M0805
RA0_GERENC_BATERIA: PINO_TORNEADO
RB5_GERENC_PRESSãO_A/C: PINO_TORNEADO

Connections:
+5V: D9.C, D10.C, D12.C, D13.C; also elsewhere on the board
GND3: C78.2, C79.2, C80.1, C81.1, C82.1, C84.1, C85.2, C103.1, IC10.4 (V-), IC11.4 (V-), R156.1; also elsewhere on the board
LINHA_15_PIN27: COND_ANA_1_IN.1, R11.1; also elsewhere on the board
unnamed: C78.1, D9.A, IC10.3 (+IN), R11.2, R156.2
unnamed: IC10.1 (OUT), IC10.2 (-IN), R12.1
unnamed: C77.1, R12.2, R104.1
unnamed: C80.2, IC10.5 (+IN), R104.2
unnamed: C103.2, D10.A, IC11.3 (+IN), R105.2
unnamed: IC11.1 (OUT), IC11.2 (-IN), R152.1
unnamed: C83.1, R107.1, R152.2
unnamed: C84.2, IC11.5 (+IN), R107.2
RB5_GERENC_PRESSãO_A/C: C83.2, C85.1, D13.A, IC11.6 (-IN), IC11.7 (OUT), RB5_GERENC_PRESSãO_A/C.1; also elsewhere on the board
RB6_GERENC_BATERIA: C77.2, C81.2, D12.A, IC10.6 (-IN), IC10.7 (OUT), RA0_GERENC_BATERIA.1; also elsewhere on the board
SENSOR_PRESSAO_A/C_PIN17: COND_ANA2_IN.1, PIN.17, R105.1
V+: C79.1, C82.2, IC10.8 (V+), IC11.8 (V+); also elsewhere on the board

Notes on the sheet:
Bateria
Circuito Condicionador Analógico Gerenciamento
Sensor de Pressão A/C
FACULDADE DE TECNOLOGIA DE SANTO ANDRÉ Rua Prefeito Justino Paixão, 150 - Centro Santo André - SP - CEP:09020-130 (11) 4437-2216
MARK 1

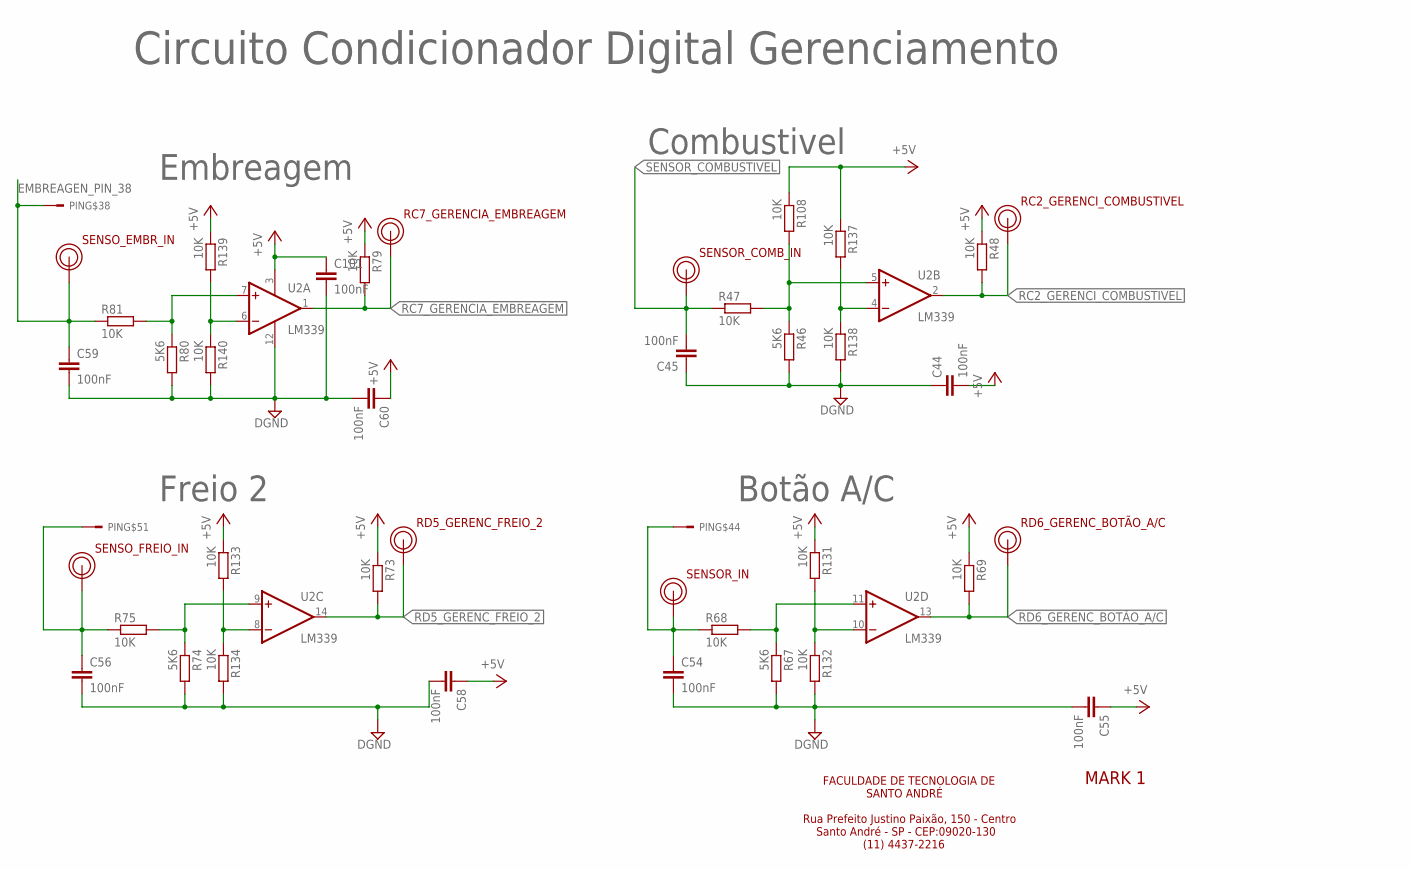
[picture p27: schematic ECU_MULT_CAR.sch, sheet 7]

Parts:
C44, C45, C54, C55, C56, C58, C59, C60, C101: 100nF; C0805
PIN: CONCTOR_BOSCH; V23542-A1280-B300
R46, R67, R74, R80: 5K6; M0805
R47, R48, R68, R69, R73, R75, R79, R81, R108, R131, R132, R133, R134, R137, R138, R139, R140: 10K; M0805
RC2_GERENCI_COMBUSTIVEL, RC7_GERENCIA_EMBREAGEM: PINO_TORNEADO
RD5_GERENC_FREIO_2, RD6_GERENC_BOTÃO_A/C: PINO_TORNEADO
SENSOR_COMB_IN: PINO_TORNEADO
SENSOR_IN: PINO_TORNEADO
SENSO_EMBR_IN: PINO_TORNEADO
SENSO_FREIO_IN: PINO_TORNEADO
U2: LM339; SOIC14N

Connections:
+5V: C44.2, C55.1, C58.1, C60.1, C101.1, R48.1, R69.1, R73.1, R79.1, R108.1, R131.1, R133.1, R137.1, R139.1, U2.3 (V+); also elsewhere on the board
BOTAO_A/C_ACION_AR_COND_PIN44: C54.1, PIN.44, R68.1, SENSOR_IN.1
DGND: C44.1, C45.1, C54.2, C55.2, C56.2, C58.2, C59.2, C60.2, C101.2, R46.2, R67.2, R74.2, R80.2, R132.2, R134.2, R138.2, R140.2, U2.12 (V-); also elsewhere on the board
EMBREAGEN_PIN_38: C59.1, PIN.38, R81.1, SENSO_EMBR_IN.1
FREIO_PIN_51: C56.1, PIN.51, R75.1, SENSO_FREIO_IN.1
unnamed: R46.1, R47.2, R108.2, U2.5 (+IN)
unnamed: R67.1, R68.2, U2.11 (+IN)
unnamed: R74.1, R75.2, U2.9 (+IN)
unnamed: R80.1, R81.2, U2.7 (+IN)
unnamed: R131.2, R132.1, U2.10 (-IN)
unnamed: R137.2, R138.1, U2.4 (-IN)
unnamed: R133.2, R134.1, U2.8 (-IN)
unnamed: R139.2, R140.1, U2.6 (-IN)
RC2_GERENCI_COMBUSTIVEL: R48.2, RC2_GERENCI_COMBUSTIVEL.1, U2.2 (OUT); also elsewhere on the board
RC7_GERENCIA_EMBREAGEM: R79.2, RC7_GERENCIA_EMBREAGEM.1, U2.1 (OUT); also elsewhere on the board
RD5_GERENC_FREIO_2: R73.2, RD5_GERENC_FREIO_2.1, U2.14 (OUT); also elsewhere on the board
RD6_GERENC_BOTÃO_A/C: R69.2, RD6_GERENC_BOTÃO_A/C.1, U2.13 (OUT); also elsewhere on the board
SENSOR_COMBUSTIVEL: C45.2, R47.1, SENSOR_COMB_IN.1; also elsewhere on the board

Notes on the sheet:
Combustivel
Botão A/C
Embreagem
Freio 2
Circuito Condicionador Digital Gerenciamento
FACULDADE DE TECNOLOGIA DE SANTO ANDRÉ Rua Prefeito Justino Paixão, 150 - Centro Santo André - SP - CEP:09020-130 (11) 4437-2216
MARK 1

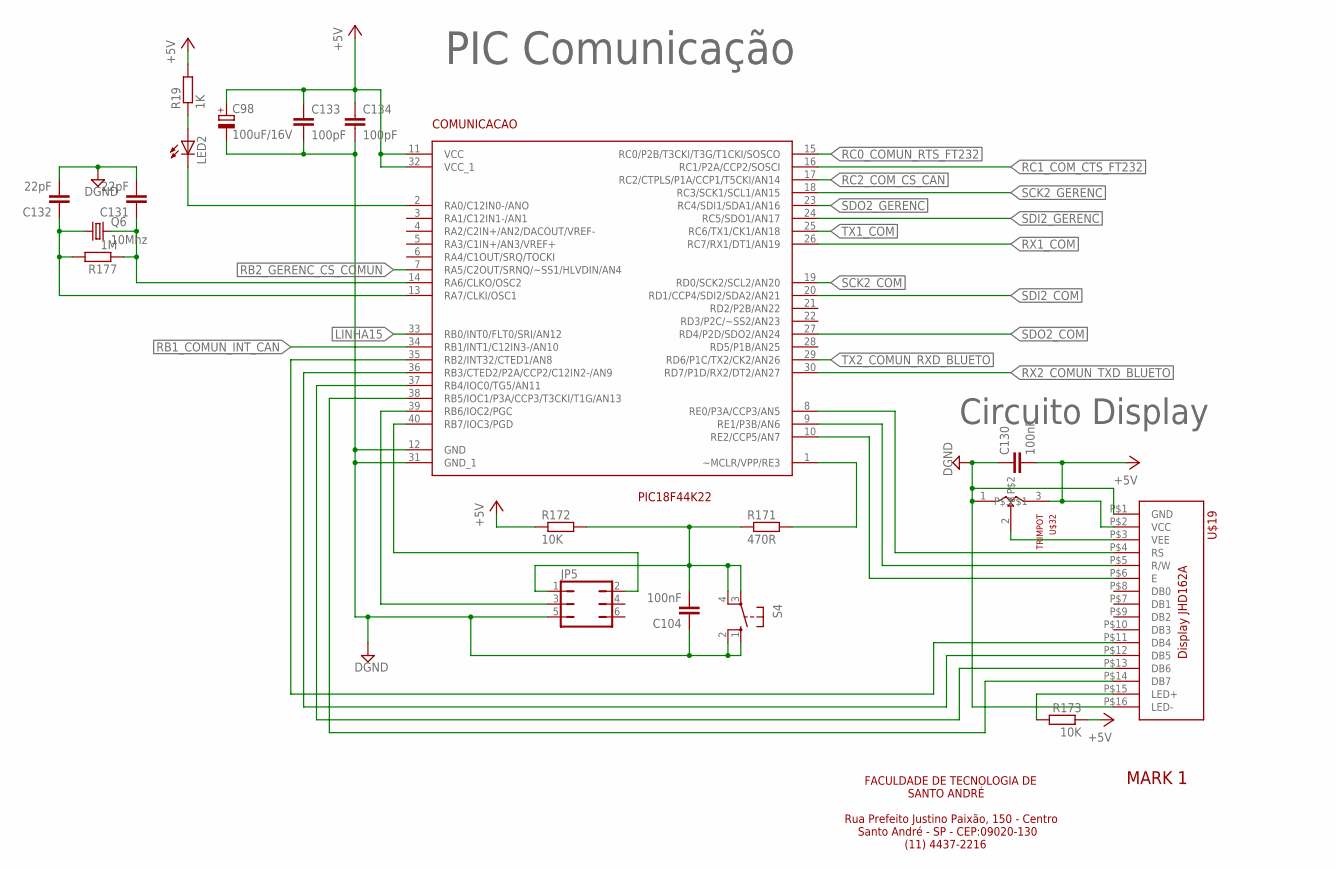
[picture p28: schematic ECU_MULT_CAR.sch, sheet 8]

Parts:
C98: 100uF/16V; E2,5-7
C104, C130: 100nF; C0805
C131, C132: 22pF; C0805
C133, C134: 100pF; C0805
COMUNICACAO: PIC18F44K22; DIP40
JP5: JP3Q
LED2: LEDKA-3528ASYC; KA-3528ASYC
Q6: 10Mhz; SM49
R19: 1K; M0805
R171: 470R; M0805
R172, R173: 10K; M0805
R177: 1M; M0805
S4: 10-XX; B3F-10XX
U$19: JHD162A
U$32: TRIMPOT

Connections:
+5V: C98.+, C130.2, C133.1, C134.1, COMUNICACAO.11 (VCC), COMUNICACAO.32 (VCC_1), R19.2, R172.1, R173.1, U$19.P$2 (VCC), U$32.3; also elsewhere on the board
DGND: C98.-, C104.1, C130.1, C131.2, C132.2, C133.2, C134.2, COMUNICACAO.12 (GND), COMUNICACAO.31 (GND_1), JP5.5, S4.1 (S), S4.2 (S1), U$19.P$1 (GND), U$19.P$16 (LED-), U$32.1; also elsewhere on the board
LINHA15: COMUNICACAO.33 (RB0/INT0/FLT0/SRI/AN12); also elsewhere on the board
unnamed: COMUNICACAO.2 (RA0/C12IN0-/ANO), LED2.C
unnamed: LED2.A, R19.1
unnamed: COMUNICACAO.38 (RB5/IOC1/P3A/CCP3/T3CKI/T1G/AN13), U$19.P$14 (DB7)
unnamed: COMUNICACAO.37 (RB4/IOC0/TG5/AN11), U$19.P$13 (DB6)
unnamed: COMUNICACAO.36 (RB3/CTED2/P2A/CCP2/C12IN2-/AN9), U$19.P$12 (DB5)
unnamed: COMUNICACAO.35 (RB2/INT32/CTED1/AN8), U$19.P$11 (DB4)
unnamed: C104.2, JP5.1, R171.1, R172.2, S4.3, S4.4 (P1)
unnamed: COMUNICACAO.40 (RB7/IOC3/PGD), JP5.2
unnamed: COMUNICACAO.1 (~MCLR/VPP/RE3), R171.2
unnamed: C131.1, COMUNICACAO.14 (RA6/CLKO/OSC2), Q6.2, R177.1
unnamed: R173.2, U$19.P$15 (LED+)
unnamed: U$19.P$3 (VEE), U$32.2
unnamed: C132.1, COMUNICACAO.13 (RA7/CLKI/OSC1), Q6.1, R177.2
unnamed: COMUNICACAO.39 (RB6/IOC2/PGC), JP5.3
unnamed: COMUNICACAO.8 (RE0/P3A/CCP3/AN5), U$19.P$4 (RS)
unnamed: COMUNICACAO.9 (RE1/P3B/AN6), U$19.P$5 (R/W)
unnamed: COMUNICACAO.10 (RE2/CCP5/AN7), U$19.P$6 (E)
RB1_COMUN_INT_CAN: COMUNICACAO.34 (RB1/INT1/C12IN3-/AN10); also elsewhere on the board
RB2_GERENC_CS_COMUN: COMUNICACAO.7 (RA5/C2OUT/SRNQ/~SS1/HLVDIN/AN4); also elsewhere on the board
RC0_COMUN_RTS_FT232: COMUNICACAO.15 (RC0/P2B/T3CKI/T3G/T1CKI/SOSCO); also elsewhere on the board
RC1_COM_CTS_FT232: COMUNICACAO.16 (RC1/P2A/CCP2/SOSCI); also elsewhere on the board
RC2_COM_CS_CAN: COMUNICACAO.17 (RC2/CTPLS/P1A/CCP1/T5CKI/AN14); also elsewhere on the board
RX1_COM: COMUNICACAO.26 (RC7/RX1/DT1/AN19); also elsewhere on the board
RX2_COMUN_TXD_BLUETO: COMUNICACAO.30 (RD7/P1D/RX2/DT2/AN27); also elsewhere on the board
SCK2_COM: COMUNICACAO.19 (RD0/SCK2/SCL2/AN20); also elsewhere on the board
SCK2_GERENC: COMUNICACAO.18 (RC3/SCK1/SCL1/AN15); also elsewhere on the board
SDI2_COM: COMUNICACAO.20 (RD1/CCP4/SDI2/SDA2/AN21); also elsewhere on the board
SDI2_GERENC: COMUNICACAO.24 (RC5/SDO1/AN17); also elsewhere on the board
SDO2_COM: COMUNICACAO.27 (RD4/P2D/SDO2/AN24); also elsewhere on the board
SDO2_GERENC: COMUNICACAO.23 (RC4/SDI1/SDA1/AN16); also elsewhere on the board
TX1_COM: COMUNICACAO.25 (RC6/TX1/CK1/AN18); also elsewhere on the board
TX2_COMUN_RXD_BLUETO: COMUNICACAO.29 (RD6/P1C/TX2/CK2/AN26); also elsewhere on the board

Notes on the sheet:
Circuito Display
PIC Comunicação
FACULDADE DE TECNOLOGIA DE SANTO ANDRÉ Rua Prefeito Justino Paixão, 150 - Centro Santo André - SP - CEP:09020-130 (11) 4437-2216
MARK 1

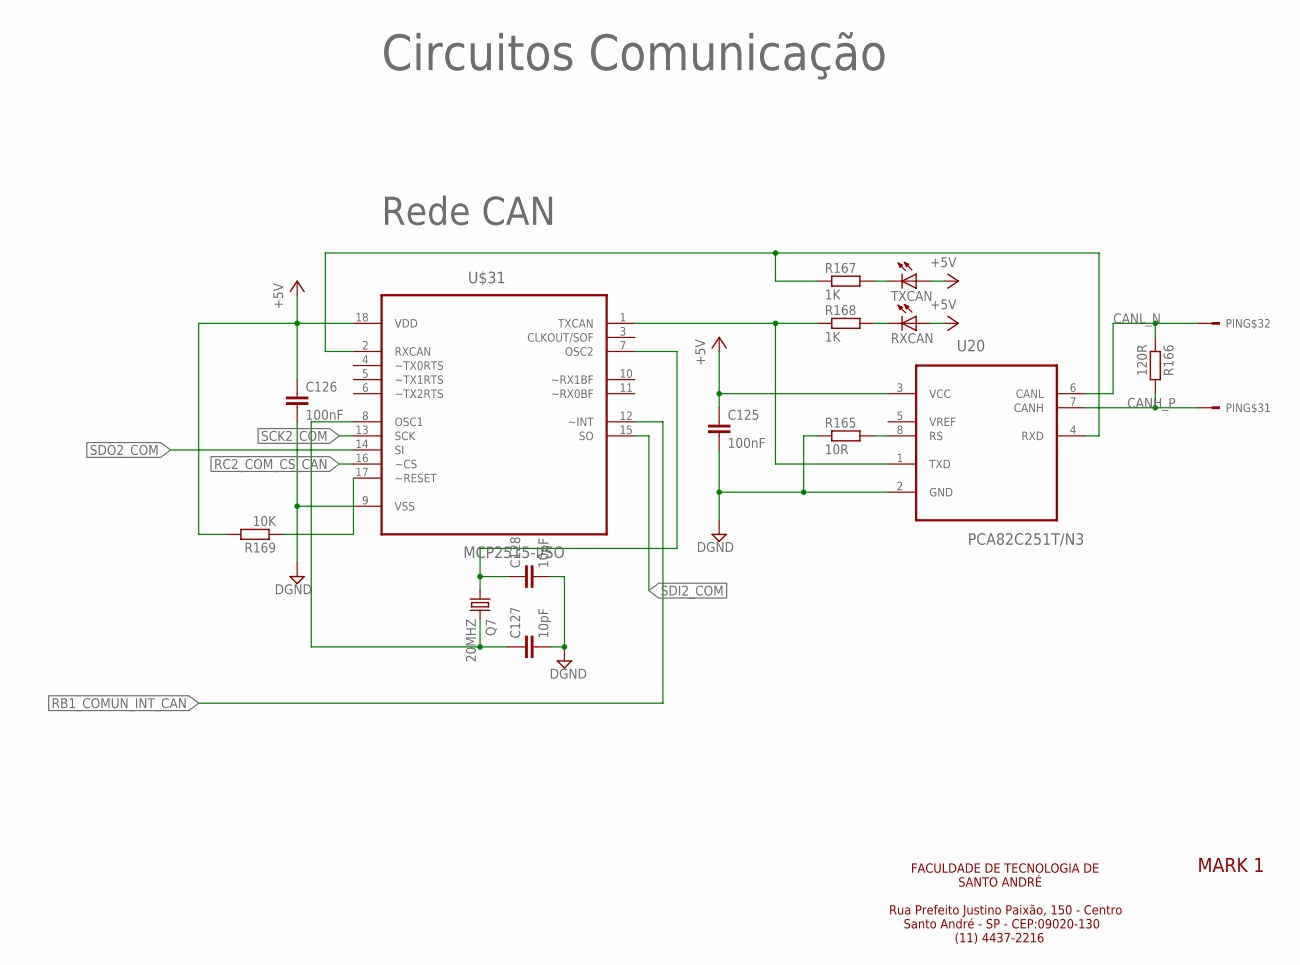
[picture p29: schematic ECU_MULT_CAR.sch, sheet 9]

Parts:
C125, C126: 100nF; C0805
C127, C128: 10pF; C0805
PIN: CONCTOR_BOSCH; V23542-A1280-B300
Q7: 20MHZ; SM49
R165: 10R; M0805
R166: 120R; M0805
R167, R168: 1K; M0805
R169: 10K; M0805
RXCAN: LEDKA-3528ASYC; KA-3528ASYC
TXCAN: LEDKA-3528ASYC; KA-3528ASYC
U20: PCA82C251T/N3; SOIC127P600X175-8N
U$31: MCP2515-I/SO; SOIC127P1034X264-18N

Connections:
+5V: C125.1, C126.1, R169.2, RXCAN.A, TXCAN.A, U20.3 (VCC), U$31.18 (VDD); also elsewhere on the board
CANH_P: PIN.31, R166.2, U20.7 (CANH)
CANL_N: PIN.32, R166.1, U20.6 (CANL)
DGND: C125.2, C126.2, C127.2, C128.2, R165.1, U20.2 (GND), U$31.9 (VSS); also elsewhere on the board
unnamed: R165.2, U20.8 (RS)
unnamed: R167.2, TXCAN.C
unnamed: R168.2, RXCAN.C
unnamed: R168.1, U20.1 (TXD), U$31.1 (TXCAN)
unnamed: R167.1, U20.4 (RXD), U$31.2 (RXCAN)
unnamed: C127.1, Q7.2, U$31.8 (OSC1)
unnamed: C128.1, Q7.1, U$31.7 (OSC2)
unnamed: R169.1, U$31.17 (~RESET)
RB1_COMUN_INT_CAN: U$31.12 (~INT); also elsewhere on the board
RC2_COM_CS_CAN: U$31.16 (~CS); also elsewhere on the board
SCK2_COM: U$31.13 (SCK); also elsewhere on the board
SDI2_COM: U$31.15 (SO); also elsewhere on the board
SDO2_COM: U$31.14 (SI); also elsewhere on the board

Notes on the sheet:
Circuitos Comunicação
Rede CAN
FACULDADE DE TECNOLOGIA DE SANTO ANDRÉ Rua Prefeito Justino Paixão, 150 - Centro Santo André - SP - CEP:09020-130 (11) 4437-2216
MARK 1
