gusmaoWilliam/FATECSO_PIC_ECU/Hardware Placa Verde PIC/layout/ECU_MULT_CAR.brd

## EAGLE design Hardware Placa Verde PIC/layout/ECU_MULT_CAR.brd (continued)

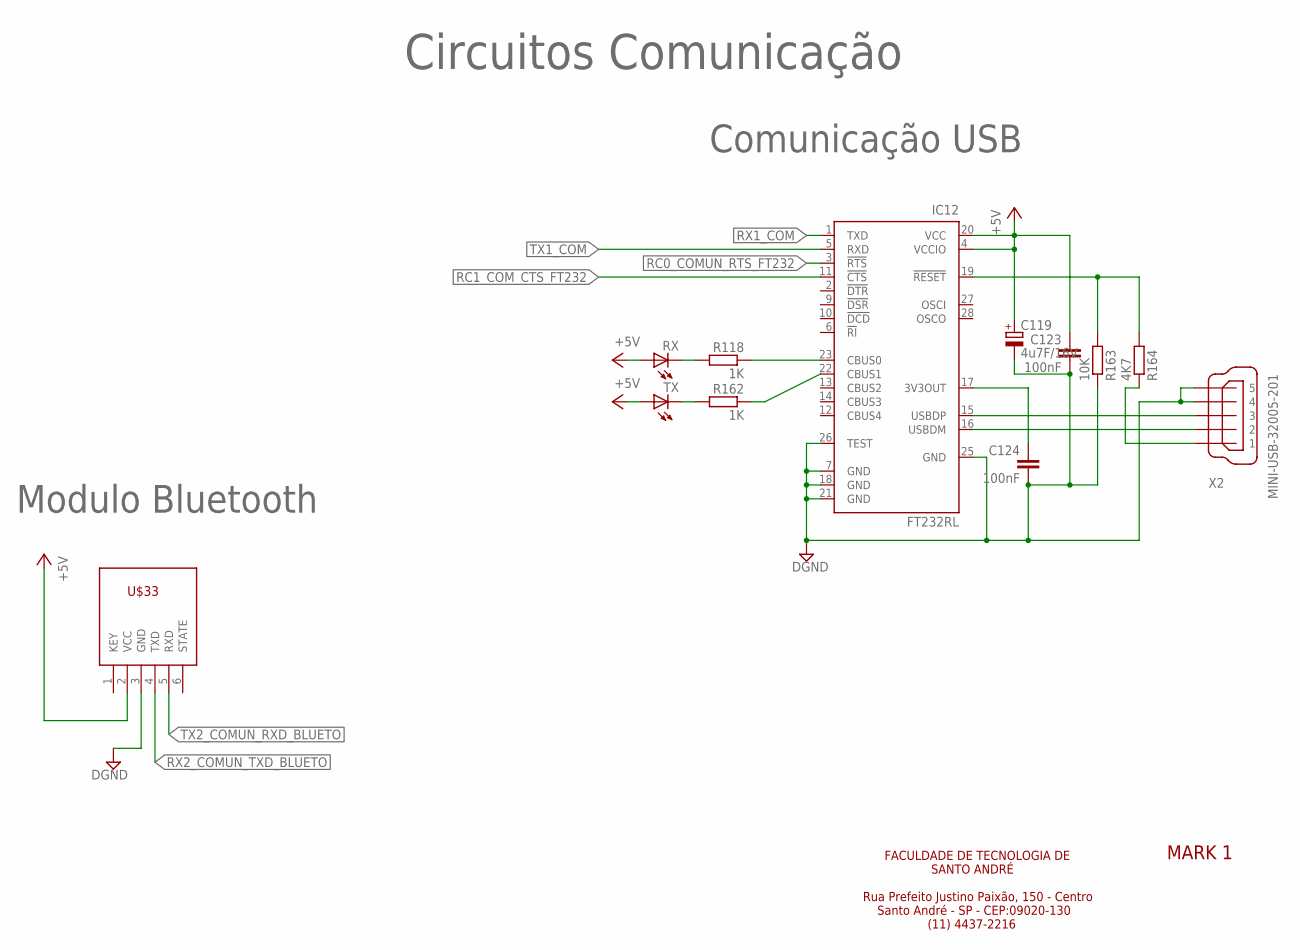
[picture p30: schematic ECU_MULT_CAR.sch, sheet 10]

Parts:
C119: 4u7F/16V; E2,5-7
C123, C124: 100nF; C0805
IC12: FT232RL; SSOP28
R118, R162: 1K; M0805
R163: 10K; M0805
R164: 4K7; M0805
RX: LEDKA-3528ASYC; KA-3528ASYC
TX: LEDKA-3528ASYC; KA-3528ASYC
U$33: HC-06; FE06
X2: MINI-USB-32005-201; 32005-201

Connections:
+5V: C119.+, C123.1, IC12.4 (VCCIO), IC12.20 (VCC), RX.A, TX.A, U$33.2 (VCC); also elsewhere on the board
DGND: C119.-, C123.2, C124.2, IC12.7 (GND), IC12.18 (GND), IC12.21 (GND), IC12.25 (GND), IC12.26 (TEST), R163.1, U$33.3 (GND), X2.4, X2.5; also elsewhere on the board
unnamed: IC12.16 (USBDM), X2.2
unnamed: IC12.15 (USBDP), X2.3
unnamed: C124.1, IC12.17 (3V3OUT)
unnamed: R118.2, RX.C
unnamed: IC12.23 (CBUS0), R118.1
unnamed: R162.2, TX.C
unnamed: IC12.22 (CBUS1), R162.1
unnamed: IC12.19 (!RESET), R163.2, R164.2
unnamed: R164.1, X2.1
RC0_COMUN_RTS_FT232: IC12.3 (!RTS); also elsewhere on the board
RC1_COM_CTS_FT232: IC12.11 (!CTS); also elsewhere on the board
RX1_COM: IC12.1 (TXD); also elsewhere on the board
RX2_COMUN_TXD_BLUETO: U$33.4 (TXD); also elsewhere on the board
TX1_COM: IC12.5 (RXD); also elsewhere on the board
TX2_COMUN_RXD_BLUETO: U$33.5 (RXD); also elsewhere on the board

Notes on the sheet:
Circuitos Comunicação
Comunicação USB
Modulo Bluetooth
FACULDADE DE TECNOLOGIA DE SANTO ANDRÉ Rua Prefeito Justino Paixão, 150 - Centro Santo André - SP - CEP:09020-130 (11) 4437-2216
MARK 1

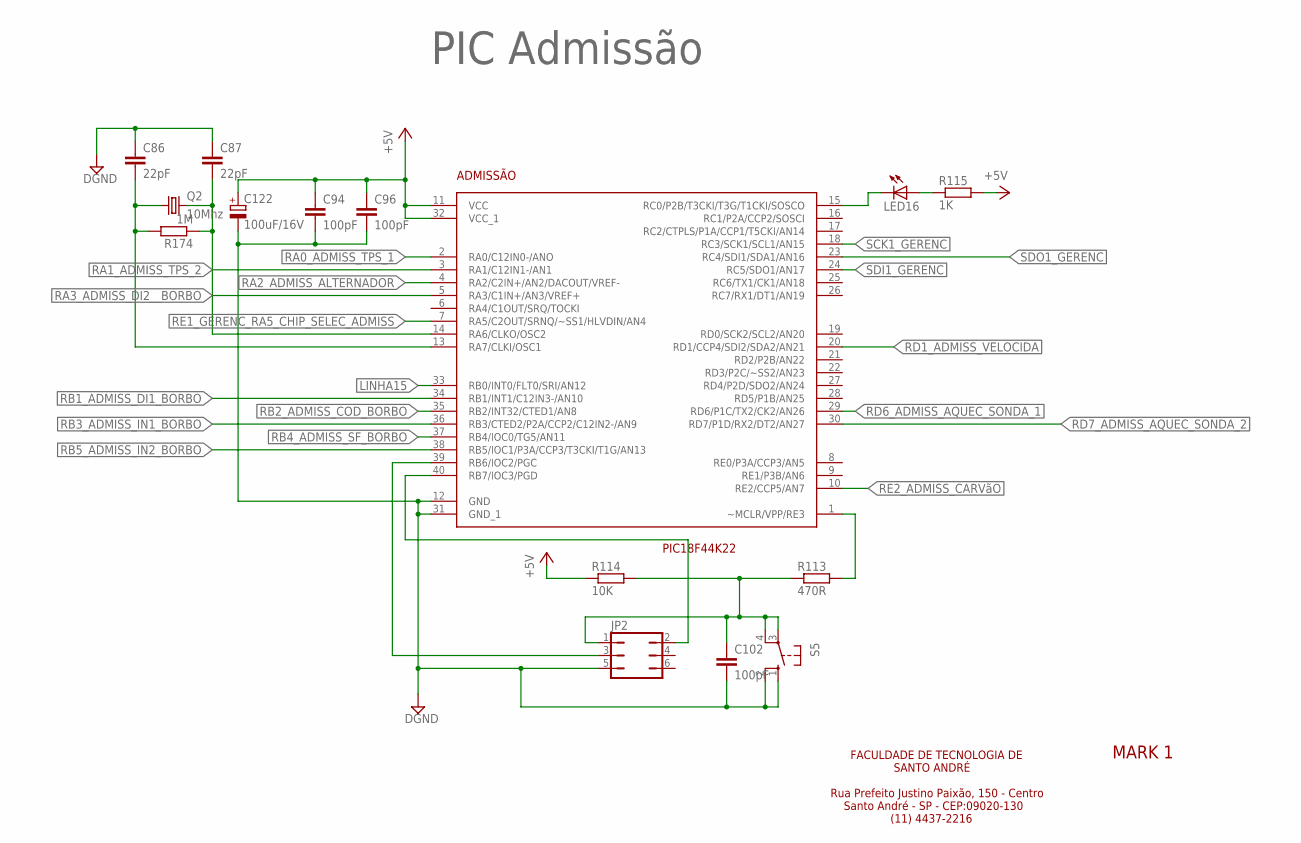
[picture p31: schematic ECU_MULT_CAR.sch, sheet 11]

Parts:
ADMISSÃO: PIC18F44K22; DIP40
C86, C87: 22pF; C0805
C94, C96, C102: 100pF; C0805
C122: 100uF/16V; E2,5-7
JP2: JP3Q
LED16: LEDKA-3528ASYC; KA-3528ASYC
Q2: 10Mhz; SM49
R113: 470R; M0805
R114: 10K; M0805
R115: 1K; M0805
R174: 1M; M0805
S5: 10-XX; B3F-10XX

Connections:
+5V: ADMISSÃO.11 (VCC), ADMISSÃO.32 (VCC_1), C94.1, C96.1, C122.+, R114.1, R115.2; also elsewhere on the board
DGND: ADMISSÃO.12 (GND), ADMISSÃO.31 (GND_1), C86.1, C87.1, C94.2, C96.2, C102.2, C122.-, JP2.5, S5.1 (S), S5.2 (S1); also elsewhere on the board
LINHA15: ADMISSÃO.33 (RB0/INT0/FLT0/SRI/AN12); also elsewhere on the board
unnamed: ADMISSÃO.15 (RC0/P2B/T3CKI/T3G/T1CKI/SOSCO), LED16.C
unnamed: LED16.A, R115.1
unnamed: ADMISSÃO.13 (RA7/CLKI/OSC1), C86.2, Q2.1, R174.2
unnamed: ADMISSÃO.1 (~MCLR/VPP/RE3), R113.2
unnamed: C102.1, JP2.1, R113.1, R114.2, S5.3, S5.4 (P1)
unnamed: ADMISSÃO.14 (RA6/CLKO/OSC2), C87.2, Q2.2, R174.1
RA0_ADMISS_TPS_1: ADMISSÃO.2 (RA0/C12IN0-/ANO); also elsewhere on the board
RA1_ADMISS_TPS_2: ADMISSÃO.3 (RA1/C12IN1-/AN1); also elsewhere on the board
RA2_ADMISS_ALTERNADOR: ADMISSÃO.4 (RA2/C2IN+/AN2/DACOUT/VREF-); also elsewhere on the board
RA3_ADMISS_DI2__BORBO: ADMISSÃO.5 (RA3/C1IN+/AN3/VREF+); also elsewhere on the board
RB1_ADMISS_DI1_BORBO: ADMISSÃO.34 (RB1/INT1/C12IN3-/AN10); also elsewhere on the board
RB2_ADMISS_COD_BORBO: ADMISSÃO.35 (RB2/INT32/CTED1/AN8); also elsewhere on the board
RB3_ADMISS_IN1_BORBO: ADMISSÃO.36 (RB3/CTED2/P2A/CCP2/C12IN2-/AN9); also elsewhere on the board
RB4_ADMISS_SF_BORBO: ADMISSÃO.37 (RB4/IOC0/TG5/AN11); also elsewhere on the board
RB5_ADMISS_IN2_BORBO: ADMISSÃO.38 (RB5/IOC1/P3A/CCP3/T3CKI/T1G/AN13); also elsewhere on the board
RB6_ADMISS: ADMISSÃO.39 (RB6/IOC2/PGC), JP2.3
RB7_ADMISS: ADMISSÃO.40 (RB7/IOC3/PGD), JP2.2
RD1_ADMISS_VELOCIDA: ADMISSÃO.20 (RD1/CCP4/SDI2/SDA2/AN21); also elsewhere on the board
RD6_ADMISS_AQUEC_SONDA_1: ADMISSÃO.29 (RD6/P1C/TX2/CK2/AN26); also elsewhere on the board
RD7_ADMISS_AQUEC_SONDA_2: ADMISSÃO.30 (RD7/P1D/RX2/DT2/AN27); also elsewhere on the board
RE1_GERENC_RA5_CHIP_SELEC_ADMISS: ADMISSÃO.7 (RA5/C2OUT/SRNQ/~SS1/HLVDIN/AN4); also elsewhere on the board
RE2_ADMISS_CARVãO: ADMISSÃO.10 (RE2/CCP5/AN7); also elsewhere on the board
SCK1_GERENC: ADMISSÃO.18 (RC3/SCK1/SCL1/AN15); also elsewhere on the board
SDI1_GERENC: ADMISSÃO.24 (RC5/SDO1/AN17); also elsewhere on the board
SDO1_GERENC: ADMISSÃO.23 (RC4/SDI1/SDA1/AN16); also elsewhere on the board

Notes on the sheet:
PIC Admissão
FACULDADE DE TECNOLOGIA DE SANTO ANDRÉ Rua Prefeito Justino Paixão, 150 - Centro Santo André - SP - CEP:09020-130 (11) 4437-2216
MARK 1

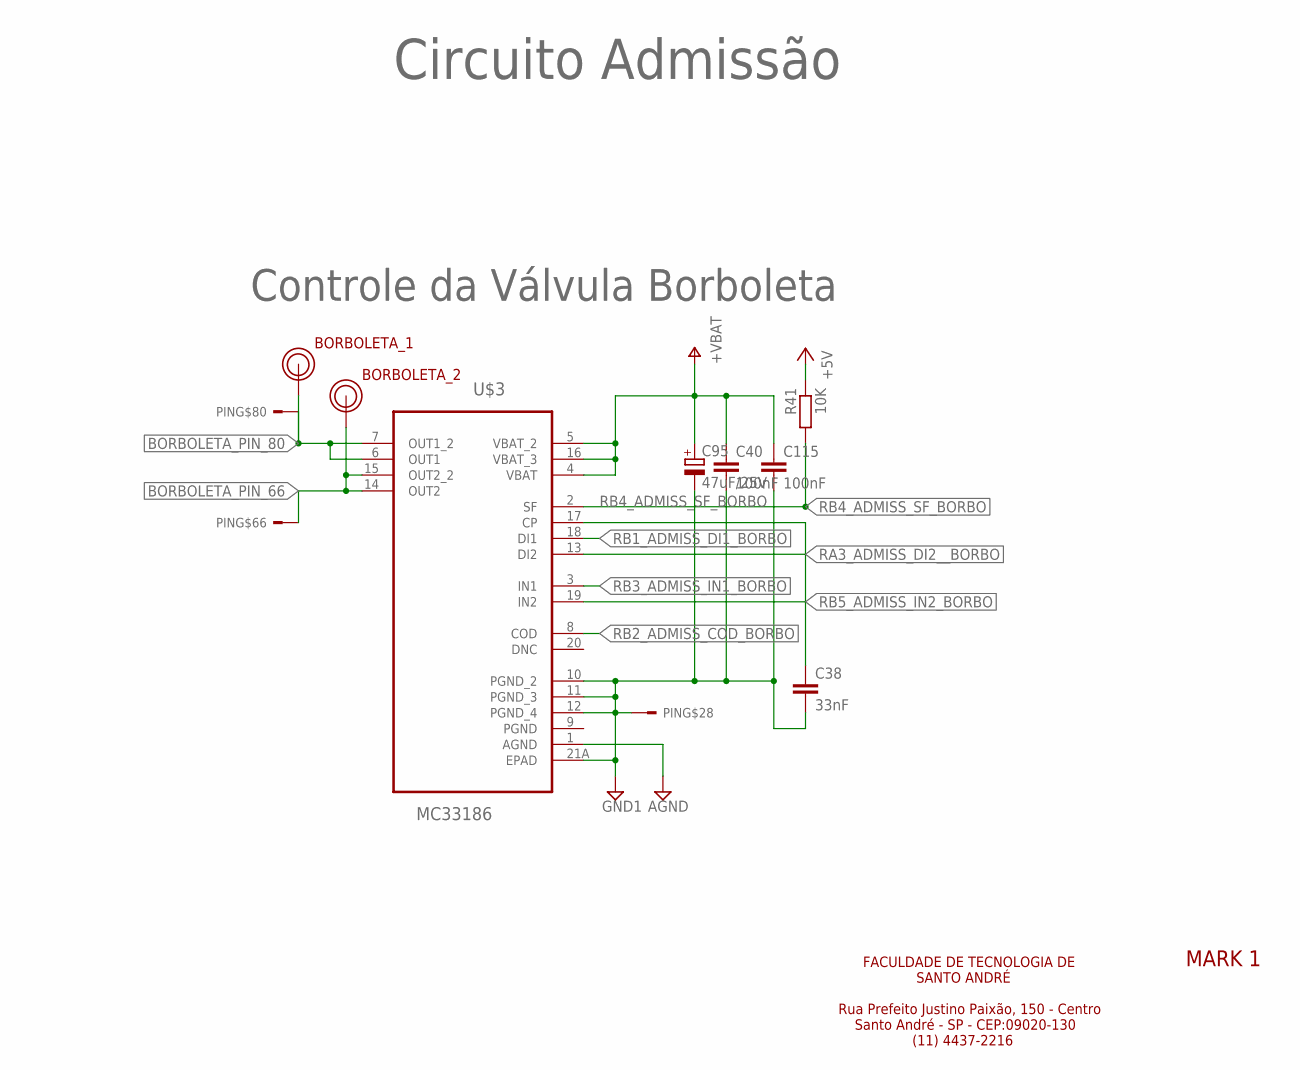
[picture p32: schematic ECU_MULT_CAR.sch, sheet 12]

Parts:
BORBOLETA_1, BORBOLETA_2: PINO_TORNEADO
C38: 33nF; C0805
C40, C115: 100nF; C0805
C95: 47uF/25V; E2,5-7
PIN: CONCTOR_BOSCH; V23542-A1280-B300
R41: 10K; M0805
U$3: MC33186; HSOP-20-PIN

Connections:
+5V: R41.1; also elsewhere on the board
BORBOLETA_PIN_66: BORBOLETA_2.1, PIN.66, U$3.14 (OUT2), U$3.15 (OUT2_2)
BORBOLETA_PIN_80: BORBOLETA_1.1, PIN.80, U$3.6 (OUT1), U$3.7 (OUT1_2)
GND3: U$3.1 (AGND); also elsewhere on the board
IGND: C38.2, C40.2, C95.-, C115.2, PIN.28, U$3.10 (PGND_2), U$3.11 (PGND_3), U$3.12 (PGND_4), U$3.21A (EPAD); also elsewhere on the board
LINHA_15_PIN27: C40.1, C95.+, C115.1, U$3.4 (VBAT), U$3.5 (VBAT_2), U$3.16 (VBAT_3); also elsewhere on the board
unnamed: C38.1, U$3.17 (CP)
RA3_ADMISS_DI2__BORBO: U$3.13 (DI2); also elsewhere on the board
RB1_ADMISS_DI1_BORBO: U$3.18 (DI1); also elsewhere on the board
RB2_ADMISS_COD_BORBO: U$3.8 (COD); also elsewhere on the board
RB3_ADMISS_IN1_BORBO: U$3.3 (IN1); also elsewhere on the board
RB4_ADMISS_SF_BORBO: R41.2, U$3.2 (SF); also elsewhere on the board
RB5_ADMISS_IN2_BORBO: U$3.19 (IN2); also elsewhere on the board

Notes on the sheet:
Controle da Válvula Borboleta
Circuito Admissão
FACULDADE DE TECNOLOGIA DE SANTO ANDRÉ Rua Prefeito Justino Paixão, 150 - Centro Santo André - SP - CEP:09020-130 (11) 4437-2216
MARK 1

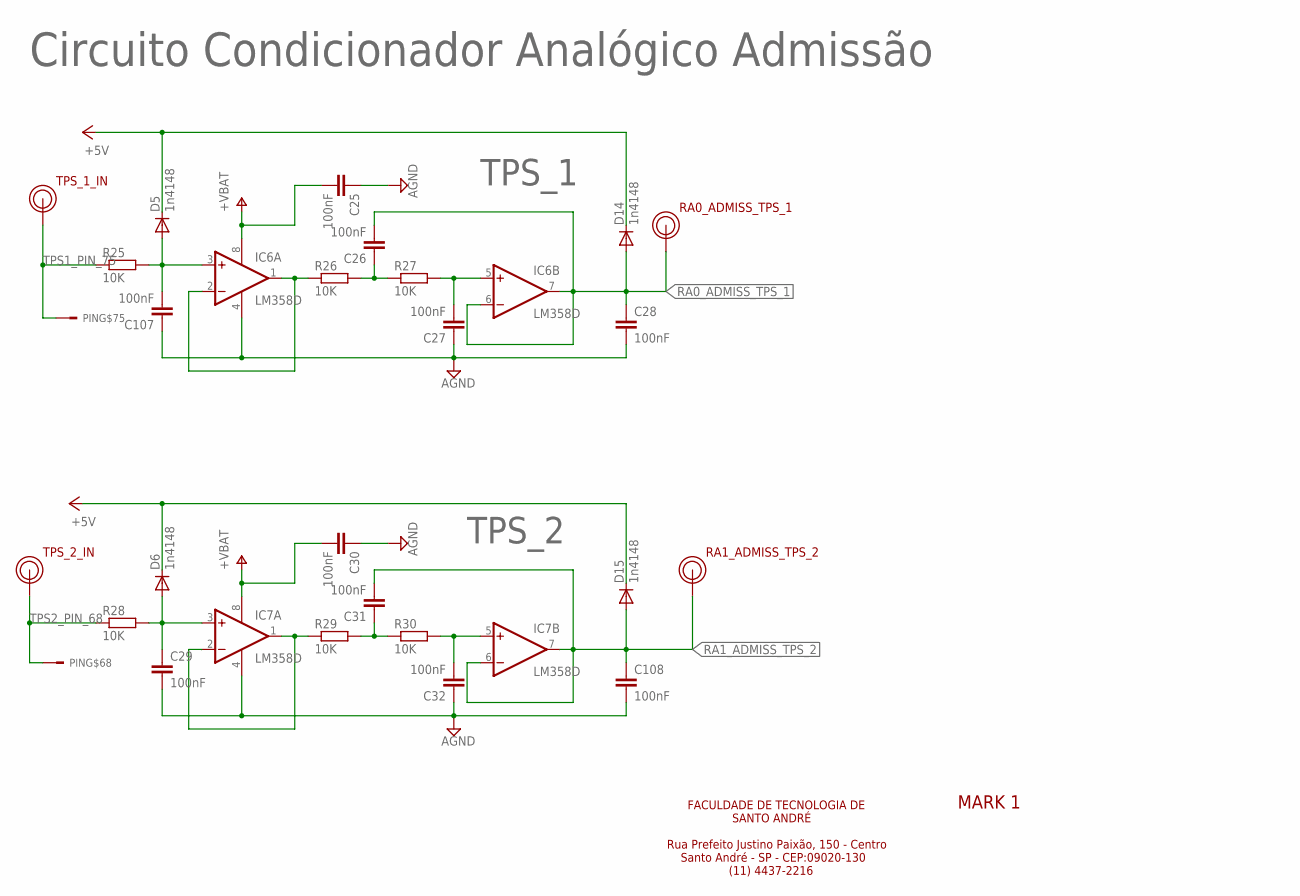
[picture p33: schematic ECU_MULT_CAR.sch, sheet 13]

Parts:
C25, C26, C27, C28, C29, C30, C31, C32, C107, C108: 100nF; C0805
D5, D6, D14, D15: 1n4148; MINIMELF
IC6, IC7: LM358D; SO08
PIN: CONCTOR_BOSCH; V23542-A1280-B300
R25, R26, R27, R28, R29, R30: 10K; M0805
RA0_ADMISS_TPS_1, RA1_ADMISS_TPS_2: PINO_TORNEADO
TPS_1_IN, TPS_2_IN: PINO_TORNEADO

Connections:
+5V: D5.C, D6.C, D14.C, D15.C; also elsewhere on the board
GND3: C25.1, C27.1, C28.2, C29.2, C30.1, C32.1, C107.1, C108.2, IC6.4 (V-), IC7.4 (V-); also elsewhere on the board
unnamed: C107.2, D5.A, IC6.3 (+IN), R25.2
unnamed: IC6.1 (OUT), IC6.2 (-IN), R26.1
unnamed: C26.1, R26.2, R27.1
unnamed: C27.2, IC6.5 (+IN), R27.2
unnamed: C29.1, D6.A, IC7.3 (+IN), R28.2
unnamed: IC7.1 (OUT), IC7.2 (-IN), R29.1
unnamed: C31.1, R29.2, R30.1
unnamed: C32.2, IC7.5 (+IN), R30.2
RA0_ADMISS_TPS_1: C26.2, C28.1, D14.A, IC6.6 (-IN), IC6.7 (OUT), RA0_ADMISS_TPS_1.1; also elsewhere on the board
RA1_ADMISS_TPS_2: C31.2, C108.1, D15.A, IC7.6 (-IN), IC7.7 (OUT), RA1_ADMISS_TPS_2.1; also elsewhere on the board
TPS1_PIN_75: PIN.75, R25.1, TPS_1_IN.1
TPS2_PIN_68: PIN.68, R28.1, TPS_2_IN.1
V+: C25.2, C30.2, IC6.8 (V+), IC7.8 (V+); also elsewhere on the board

Notes on the sheet:
Circuito Condicionador Analógico Admissão
TPS_1
TPS_2
FACULDADE DE TECNOLOGIA DE SANTO ANDRÉ Rua Prefeito Justino Paixão, 150 - Centro Santo André - SP - CEP:09020-130 (11) 4437-2216
MARK 1

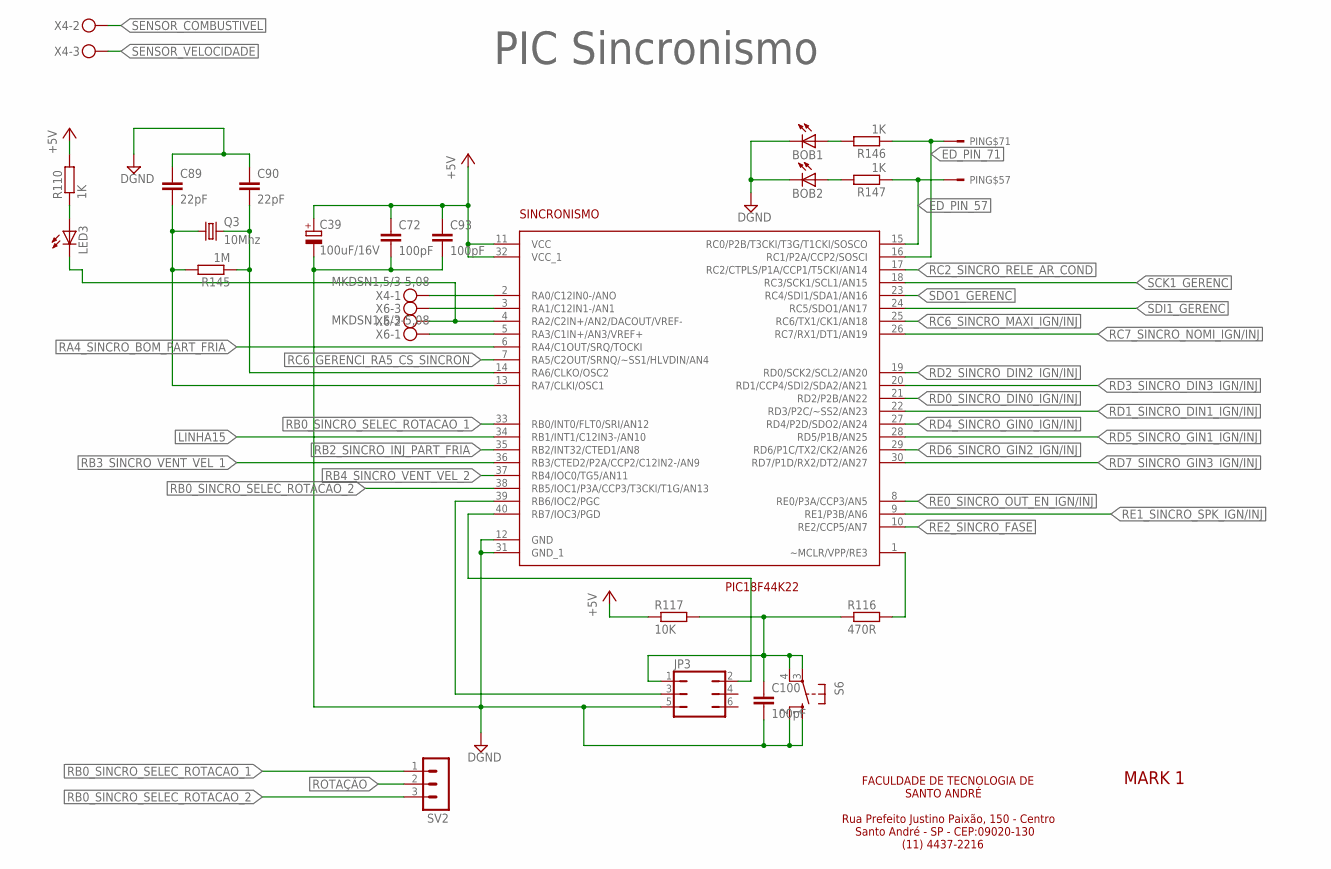
[picture p34: schematic ECU_MULT_CAR.sch, sheet 14]

Parts:
BOB1, BOB2: LEDKA-3528ASYC; KA-3528ASYC
C39: 100uF/16V; E2,5-7
C72, C93, C100: 100pF; C0805
C89, C90: 22pF; C0805
JP3: JP3Q
LED3: LEDKA-3528ASYC; KA-3528ASYC
PIN: CONCTOR_BOSCH; V23542-A1280-B300
Q3: 10Mhz; SM49
R110, R146, R147: 1K; M0805
R116: 470R; M0805
R117: 10K; M0805
R145: 1M; M0805
S6: 10-XX; B3F-10XX
SINCRONISMO: PIC18F44K22; DIP40
SV2: MA03-1
X4, X6: MKDSN1,5/3-5,08

Connections:
+5V: C39.+, C72.1, C93.1, R110.2, R117.1, SINCRONISMO.11 (VCC), SINCRONISMO.32 (VCC_1); also elsewhere on the board
DGND: BOB1.C, BOB2.C, C39.-, C72.2, C89.1, C90.1, C93.2, C100.2, JP3.5, S6.1 (S), S6.2 (S1), SINCRONISMO.12 (GND), SINCRONISMO.31 (GND_1); also elsewhere on the board
ED_PIN_57: PIN.57, R147.1, SINCRONISMO.15 (RC0/P2B/T3CKI/T3G/T1CKI/SOSCO)
ED_PIN_71: PIN.71, R146.1, SINCRONISMO.16 (RC1/P2A/CCP2/SOSCI)
LINHA15: SINCRONISMO.34 (RB1/INT1/C12IN3-/AN10); also elsewhere on the board
unnamed: BOB1.A, R146.2
unnamed: BOB2.A, R147.2
unnamed: C89.2, Q3.1, R145.2, SINCRONISMO.13 (RA7/CLKI/OSC1)
unnamed: SINCRONISMO.2 (RA0/C12IN0-/ANO), X4.1
unnamed: LED3.A, R110.1
unnamed: C90.2, Q3.2, R145.1, SINCRONISMO.14 (RA6/CLKO/OSC2)
unnamed: LED3.C, SINCRONISMO.4 (RA2/C2IN+/AN2/DACOUT/VREF-), X6.2
unnamed: R116.2, SINCRONISMO.1 (~MCLR/VPP/RE3)
unnamed: C100.1, JP3.1, R116.1, R117.2, S6.3, S6.4 (P1)
unnamed: JP3.2, SINCRONISMO.40 (RB7/IOC3/PGD)
unnamed: JP3.3, SINCRONISMO.39 (RB6/IOC2/PGC)
unnamed: SINCRONISMO.3 (RA1/C12IN1-/AN1), X6.3
unnamed: SINCRONISMO.5 (RA3/C1IN+/AN3/VREF+), X6.1
RA4_SINCRO_BOM_PART_FRIA: SINCRONISMO.6 (RA4/C1OUT/SRQ/TOCKI); also elsewhere on the board
RB0_SINCRO_SELEC_ROTACAO_1: SINCRONISMO.33 (RB0/INT0/FLT0/SRI/AN12), SV2.1
RB0_SINCRO_SELEC_ROTACAO_2: SINCRONISMO.38 (RB5/IOC1/P3A/CCP3/T3CKI/T1G/AN13), SV2.3
RB2_SINCRO_INJ_PART_FRIA: SINCRONISMO.35 (RB2/INT32/CTED1/AN8); also elsewhere on the board
RB3_SINCRO_VENT_VEL_1: SINCRONISMO.36 (RB3/CTED2/P2A/CCP2/C12IN2-/AN9); also elsewhere on the board
RB4_SINCRO_VENT_VEL_2: SINCRONISMO.37 (RB4/IOC0/TG5/AN11); also elsewhere on the board
RC2_SINCRO_RELE_AR_COND: SINCRONISMO.17 (RC2/CTPLS/P1A/CCP1/T5CKI/AN14); also elsewhere on the board
RC6_GERENCI_RA5_CS_SINCRON: SINCRONISMO.7 (RA5/C2OUT/SRNQ/~SS1/HLVDIN/AN4); also elsewhere on the board
RC6_SINCRO_MAXI_IGN/INJ: SINCRONISMO.25 (RC6/TX1/CK1/AN18); also elsewhere on the board
RC7_SINCRO_NOMI_IGN/INJ: SINCRONISMO.26 (RC7/RX1/DT1/AN19); also elsewhere on the board
RD0_SINCRO_DIN0_IGN/INJ: SINCRONISMO.21 (RD2/P2B/AN22); also elsewhere on the board
RD1_SINCRO_DIN1_IGN/INJ: SINCRONISMO.22 (RD3/P2C/~SS2/AN23); also elsewhere on the board
RD2_SINCRO_DIN2_IGN/INJ: SINCRONISMO.19 (RD0/SCK2/SCL2/AN20); also elsewhere on the board
RD3_SINCRO_DIN3_IGN/INJ: SINCRONISMO.20 (RD1/CCP4/SDI2/SDA2/AN21); also elsewhere on the board
RD4_SINCRO_GIN0_IGN/INJ: SINCRONISMO.27 (RD4/P2D/SDO2/AN24); also elsewhere on the board
RD5_SINCRO_GIN1_IGN/INJ: SINCRONISMO.28 (RD5/P1B/AN25); also elsewhere on the board
RD6_SINCRO_GIN2_IGN/INJ: SINCRONISMO.29 (RD6/P1C/TX2/CK2/AN26); also elsewhere on the board
RD7_SINCRO_GIN3_IGN/INJ: SINCRONISMO.30 (RD7/P1D/RX2/DT2/AN27); also elsewhere on the board
RE0_SINCRO_OUT_EN_IGN/INJ: SINCRONISMO.8 (RE0/P3A/CCP3/AN5); also elsewhere on the board
RE1_SINCRO_SPK_IGN/INJ: SINCRONISMO.9 (RE1/P3B/AN6); also elsewhere on the board
RE2_SINCRO_FASE: SINCRONISMO.10 (RE2/CCP5/AN7); also elsewhere on the board
ROTAÇÃO: SV2.2; also elsewhere on the board
SCK1_GERENC: SINCRONISMO.18 (RC3/SCK1/SCL1/AN15); also elsewhere on the board
SDI1_GERENC: SINCRONISMO.24 (RC5/SDO1/AN17); also elsewhere on the board
SDO1_GERENC: SINCRONISMO.23 (RC4/SDI1/SDA1/AN16); also elsewhere on the board
SENSOR_COMBUSTIVEL: X4.2; also elsewhere on the board
SENSOR_VELOCIDADE: X4.3; also elsewhere on the board

Notes on the sheet:
PIC Sincronismo
FACULDADE DE TECNOLOGIA DE SANTO ANDRÉ Rua Prefeito Justino Paixão, 150 - Centro Santo André - SP - CEP:09020-130 (11) 4437-2216
MARK 1

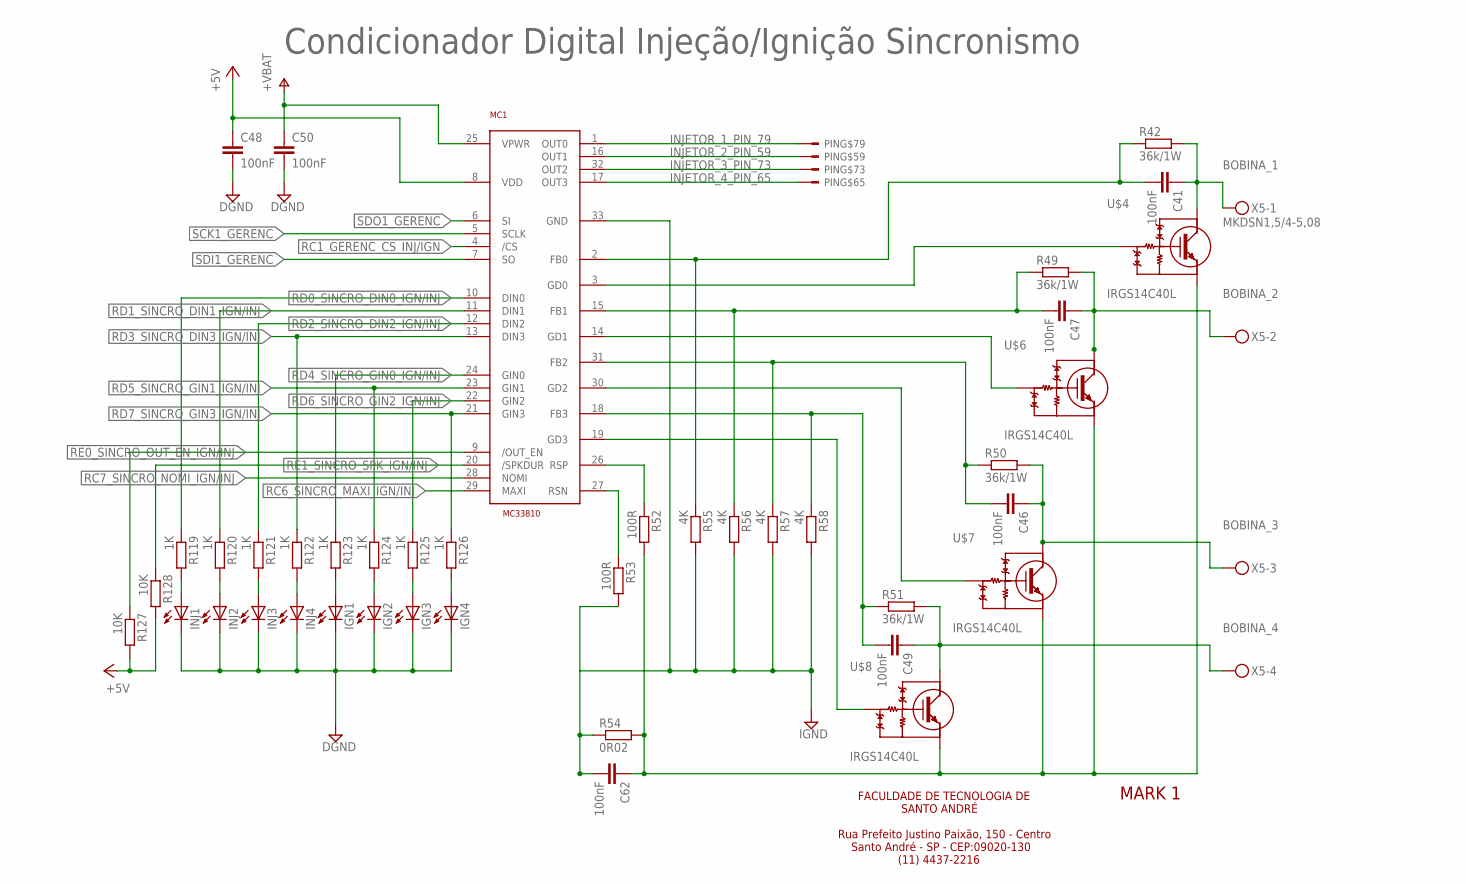
[picture p35: schematic ECU_MULT_CAR.sch, sheet 15]

Parts:
C41, C46, C47, C48, C49, C50, C62: 100nF; C0805
IGN1, IGN2, IGN3, IGN4: LEDKA-3528ASYC; KA-3528ASYC
INJ1, INJ2, INJ3, INJ4: LEDKA-3528ASYC; KA-3528ASYC
MC1: MC33810; SOIC_32_PIN
PIN: CONCTOR_BOSCH; V23542-A1280-B300
R42, R49, R50, R51: 36k/1W; R2512
R52, R53: 100R; M0805
R54: 0R02; M0805
R55, R56, R57, R58: 4K; M0805
R119, R120, R121, R122, R123, R124, R125, R126: 1K; M0805
R127, R128: 10K; M0805
U$4, U$6, U$7, U$8: IRGS14C40L; TO-263AB
X5: MKDSN1,5/4-5,08

Connections:
+5V: C48.1, MC1.8 (VDD), R127.2, R128.2; also elsewhere on the board
BOBINA_1: C41.1, R42.2, U$4.SOURCE (DRAIN), X5.1
BOBINA_2: C47.1, R49.2, U$6.SOURCE (DRAIN), X5.2
BOBINA_3: C46.1, R50.2, U$7.SOURCE (DRAIN), X5.3
BOBINA_4: C49.1, R51.2, U$8.SOURCE (DRAIN), X5.4
DGND: C48.2, C50.2, IGN1.C, IGN2.C, IGN3.C, IGN4.C, INJ1.C, INJ2.C, INJ3.C, INJ4.C; also elsewhere on the board
IGND: C62.2, MC1.33 (GND), R53.2, R54.1, R55.2, R56.2, R57.2, R58.2; also elsewhere on the board
INJETOR_1_PIN_79: MC1.1 (OUT0), PIN.79
INJETOR_2_PIN_59: MC1.16 (OUT1), PIN.59
INJETOR_3_PIN_73: MC1.32 (OUT2), PIN.73
INJETOR_4_PIN_65: MC1.17 (OUT3), PIN.65
unnamed: C41.2, MC1.2 (FB0), R42.1, R55.1
unnamed: C47.2, MC1.15 (FB1), R49.1, R56.1
unnamed: C46.2, MC1.31 (FB2), R50.1, R57.1
unnamed: C49.2, MC1.18 (FB3), R51.1, R58.1
unnamed: C62.1, R52.2, R54.2, U$4.DRAIN (SOURCE), U$6.DRAIN (SOURCE), U$7.DRAIN (SOURCE), U$8.DRAIN (SOURCE)
unnamed: MC1.3 (GD0), U$4.GATE
unnamed: MC1.14 (GD1), U$6.GATE
unnamed: MC1.30 (GD2), U$7.GATE
unnamed: MC1.19 (GD3), U$8.GATE
unnamed: MC1.26 (RSP), R52.1
unnamed: MC1.27 (RSN), R53.1
unnamed: INJ1.A, R119.2
unnamed: INJ2.A, R120.2
unnamed: INJ3.A, R121.2
unnamed: INJ4.A, R122.2
unnamed: IGN1.A, R123.2
unnamed: IGN2.A, R124.2
unnamed: IGN3.A, R125.2
unnamed: IGN4.A, R126.2
RC1_GERENC_CS_INJ/IGN: MC1.4 (/CS); also elsewhere on the board
RC6_SINCRO_MAXI_IGN/INJ: MC1.29 (MAXI); also elsewhere on the board
RC7_SINCRO_NOMI_IGN/INJ: MC1.28 (NOMI); also elsewhere on the board
RD0_SINCRO_DIN0_IGN/INJ: MC1.10 (DIN0), R119.1; also elsewhere on the board
RD1_SINCRO_DIN1_IGN/INJ: MC1.11 (DIN1), R120.1; also elsewhere on the board
RD2_SINCRO_DIN2_IGN/INJ: MC1.12 (DIN2), R121.1; also elsewhere on the board
RD3_SINCRO_DIN3_IGN/INJ: MC1.13 (DIN3), R122.1; also elsewhere on the board
RD4_SINCRO_GIN0_IGN/INJ: MC1.24 (GIN0), R123.1; also elsewhere on the board
RD5_SINCRO_GIN1_IGN/INJ: MC1.23 (GIN1), R124.1; also elsewhere on the board
RD6_SINCRO_GIN2_IGN/INJ: MC1.22 (GIN2), R125.1; also elsewhere on the board
RD7_SINCRO_GIN3_IGN/INJ: MC1.21 (GIN3), R126.1; also elsewhere on the board
RE0_SINCRO_OUT_EN_IGN/INJ: MC1.9 (/OUT_EN), R127.1; also elsewhere on the board
RE1_SINCRO_SPK_IGN/INJ: MC1.20 (/SPKDUR), R128.1; also elsewhere on the board
SCK1_GERENC: MC1.5 (SCLK); also elsewhere on the board
SDI1_GERENC: MC1.7 (SO); also elsewhere on the board
SDO1_GERENC: MC1.6 (SI); also elsewhere on the board
V+: C50.1, MC1.25 (VPWR); also elsewhere on the board

Notes on the sheet:
Condicionador Digital Injeção/Ignição Sincronismo
FACULDADE DE TECNOLOGIA DE SANTO ANDRÉ Rua Prefeito Justino Paixão, 150 - Centro Santo André - SP - CEP:09020-130 (11) 4437-2216
MARK 1

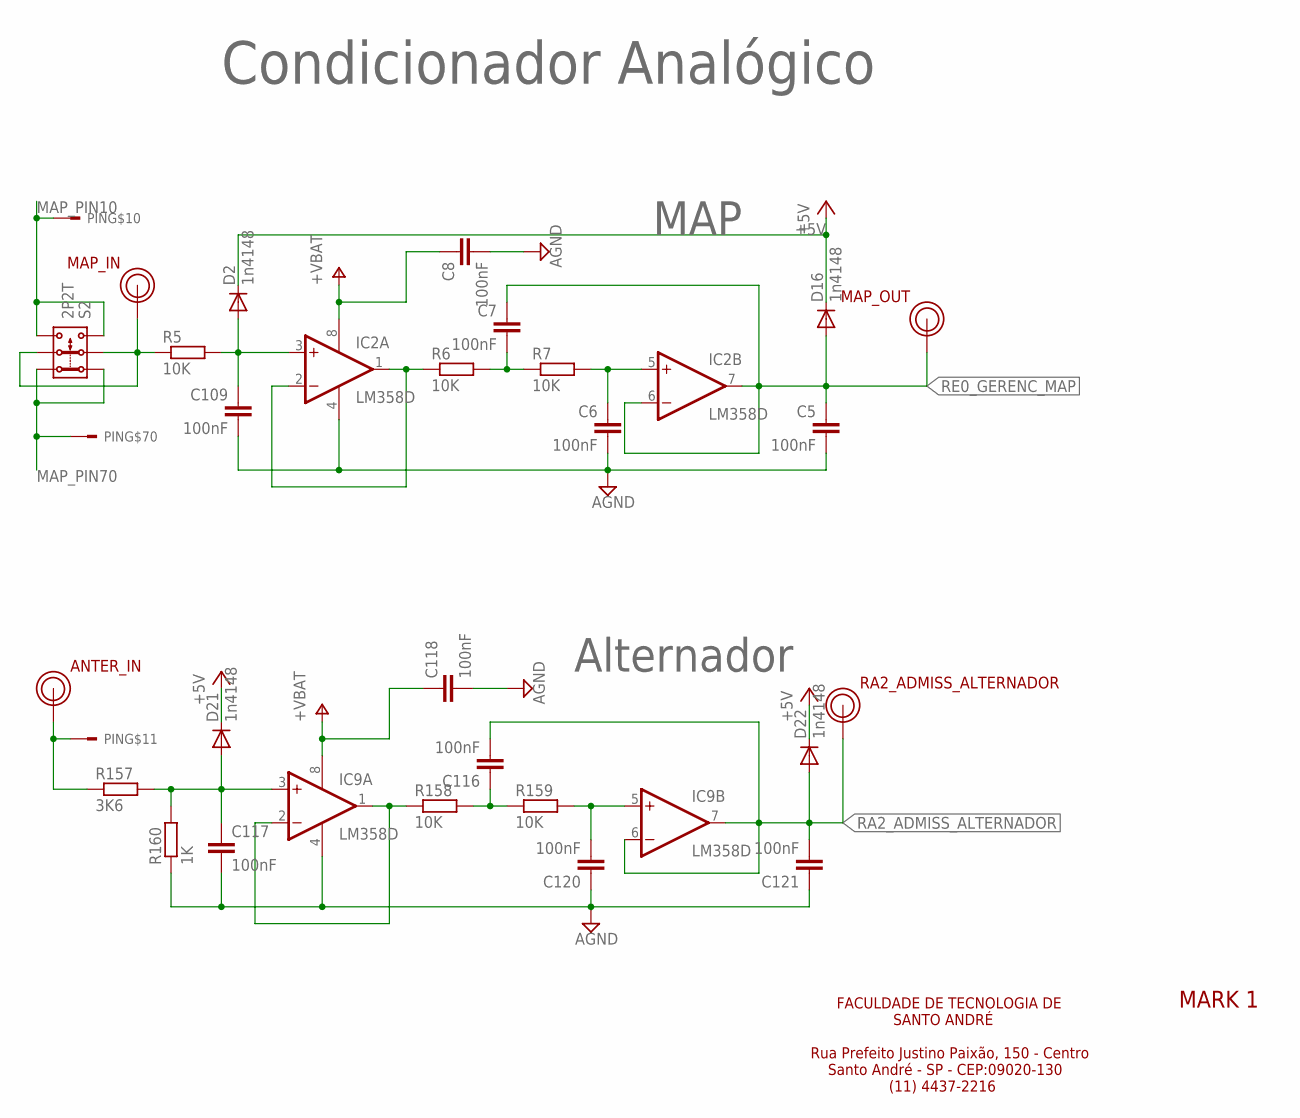
[picture p36: schematic ECU_MULT_CAR.sch, sheet 16]

Parts:
ANTER_IN: PINO_TORNEADO
C5, C6, C7, C8, C109, C116, C117, C118, C120, C121: 100nF; C0805
D2, D16, D21, D22: 1n4148; MINIMELF
IC2, IC9: LM358D; SO08
MAP_IN: PINO_TORNEADO
MAP_OUT: PINO_TORNEADO
PIN: CONCTOR_BOSCH; V23542-A1280-B300
R5, R6, R7, R158, R159: 10K; M0805
R157: 3K6; M0805
R160: 1K; M0805
RA2_ADMISS_ALTERNADOR: PINO_TORNEADO
S2: 2P2T

Connections:
+5V: D2.C, D16.C, D21.C, D22.C; also elsewhere on the board
GND3: C5.2, C6.2, C8.2, C109.2, C117.2, C118.2, C120.1, C121.1, IC2.4 (V-), IC9.4 (V-), R160.1; also elsewhere on the board
MAP_PIN10: PIN.10, S2.3.1, S2.3.2
MAP_PIN70: PIN.70, S2.1.1, S2.1.2
unnamed: C109.1, D2.A, IC2.3 (+IN), R5.2
unnamed: IC2.1 (OUT), IC2.2 (-IN), R6.1
unnamed: C7.2, R6.2, R7.1
unnamed: C6.1, IC2.5 (+IN), R7.2
unnamed: MAP_IN.1, R5.1, S2.2.1, S2.2.2
unnamed: ANTER_IN.1, PIN.11, R157.1
unnamed: C117.1, D21.A, IC9.3 (+IN), R157.2, R160.2
unnamed: IC9.1 (OUT), IC9.2 (-IN), R158.1
unnamed: C116.1, R158.2, R159.1
unnamed: C120.2, IC9.5 (+IN), R159.2
RA2_ADMISS_ALTERNADOR: C116.2, C121.2, D22.A, IC9.6 (-IN), IC9.7 (OUT), RA2_ADMISS_ALTERNADOR.1; also elsewhere on the board
RE0_GERENC_MAP: C5.1, C7.1, D16.A, IC2.6 (-IN), IC2.7 (OUT), MAP_OUT.1; also elsewhere on the board
V+: C8.1, C118.1, IC2.8 (V+), IC9.8 (V+); also elsewhere on the board

Notes on the sheet:
MAP
Alternador
Condicionador Analógico
FACULDADE DE TECNOLOGIA DE SANTO ANDRÉ Rua Prefeito Justino Paixão, 150 - Centro Santo André - SP - CEP:09020-130 (11) 4437-2216
MARK 1

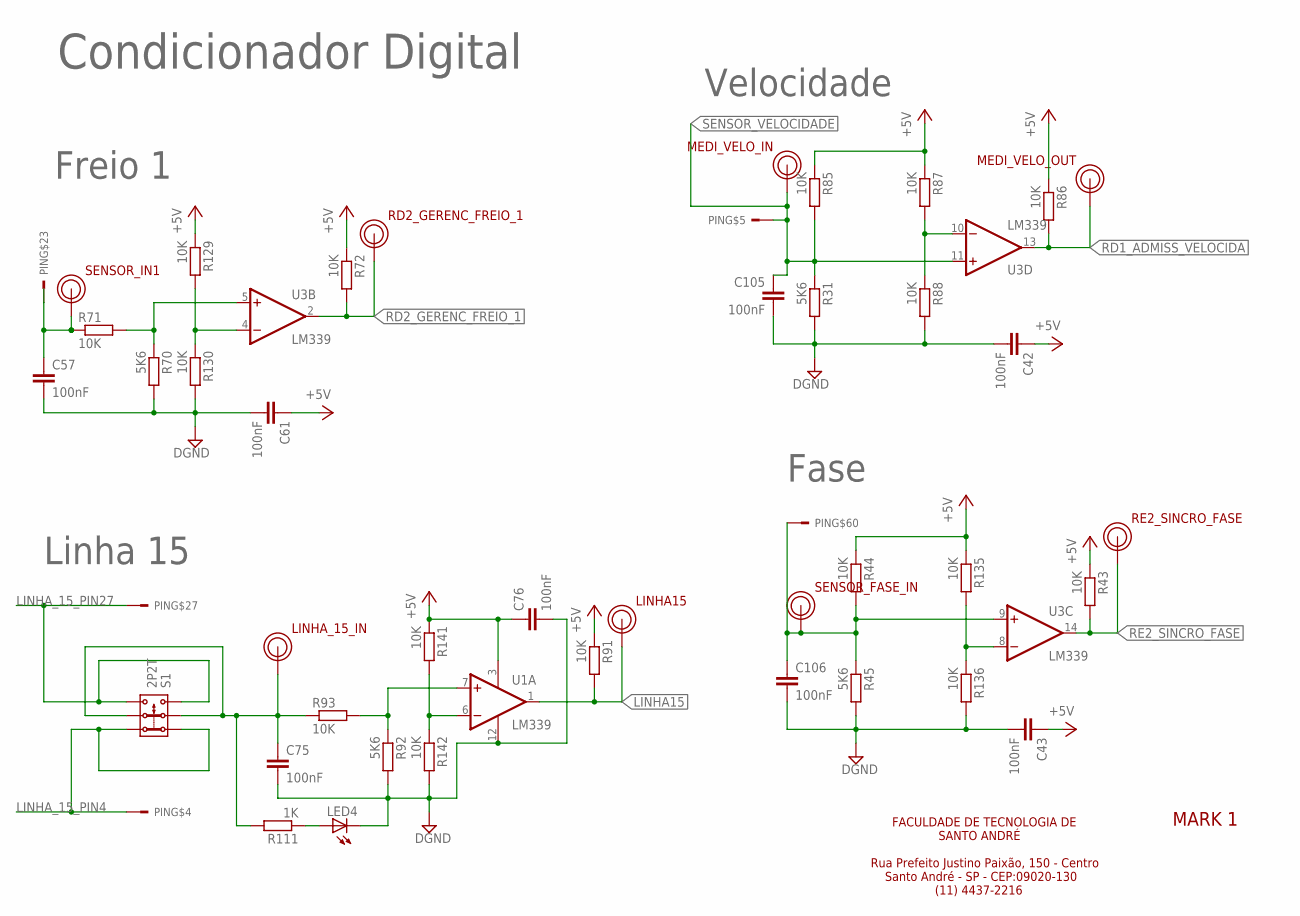
[picture p37: schematic ECU_MULT_CAR.sch, sheet 17]

Parts:
C42, C43, C57, C61, C75, C76, C105, C106: 100nF; C0805
LED4: LEDKA-3528ASYC; KA-3528ASYC
LINHA15: PINO_TORNEADO
LINHA_15_IN: PINO_TORNEADO
MEDI_VELO_IN: PINO_TORNEADO
MEDI_VELO_OUT: PINO_TORNEADO
PIN: CONCTOR_BOSCH; V23542-A1280-B300
R31, R45, R70, R92: 5K6; M0805
R43, R44, R71, R72, R85, R86, R87, R88, R91, R93, R129, R130, R135, R136, R141, R142: 10K; M0805
R111: 1K; M0805
RD2_GERENC_FREIO_1: PINO_TORNEADO
RE2_SINCRO_FASE: PINO_TORNEADO
S1: 2P2T
SENSOR_FASE_IN: PINO_TORNEADO
SENSOR_IN1: PINO_TORNEADO
U1, U3: LM339; SOIC14N

Connections:
+5V: C42.1, C43.1, C61.1, C76.1, R43.1, R44.1, R72.1, R85.1, R86.1, R87.1, R91.1, R129.1, R135.1, R141.1, U1.3 (V+); also elsewhere on the board
DGND: C42.2, C43.2, C57.2, C61.2, C75.2, C76.2, C105.2, C106.2, LED4.C, R31.2, R45.2, R70.2, R88.2, R92.2, R130.2, R136.2, R142.2, U1.12 (V-); also elsewhere on the board
LINHA15: LINHA15.1, R91.2, U1.1 (OUT); also elsewhere on the board
LINHA_15_PIN4: PIN.4, S1.1.1, S1.1.2
LINHA_15_PIN27: PIN.27, S1.3.1, S1.3.2; also elsewhere on the board
unnamed: R87.2, R88.1, U3.10 (-IN)
unnamed: R70.1, R71.2, U3.5 (+IN)
unnamed: C57.1, PIN.23, R71.1, SENSOR_IN1.1
unnamed: R129.2, R130.1, U3.4 (-IN)
unnamed: R92.1, R93.2, U1.7 (+IN)
unnamed: LED4.A, R111.1
unnamed: C75.1, LINHA_15_IN.1, R93.1, R111.2, S1.2.1, S1.2.2
unnamed: C106.1, PIN.60, R44.2, R45.1, SENSOR_FASE_IN.1, U3.9 (+IN)
unnamed: R135.2, R136.1, U3.8 (-IN)
unnamed: R141.2, R142.1, U1.6 (-IN)
RD1_ADMISS_VELOCIDA: MEDI_VELO_OUT.1, R86.2, U3.13 (OUT); also elsewhere on the board
RD2_GERENC_FREIO_1: R72.2, RD2_GERENC_FREIO_1.1, U3.2 (OUT); also elsewhere on the board
RE2_SINCRO_FASE: R43.2, RE2_SINCRO_FASE.1, U3.14 (OUT); also elsewhere on the board
SENSOR_VELOCIDADE: C105.1, MEDI_VELO_IN.1, PIN.5, R31.1, R85.2, U3.11 (+IN); also elsewhere on the board

Notes on the sheet:
Fase
Freio 1
Linha 15
Velocidade
Condicionador Digital
FACULDADE DE TECNOLOGIA DE SANTO ANDRÉ Rua Prefeito Justino Paixão, 150 - Centro Santo André - SP - CEP:09020-130 (11) 4437-2216
MARK 1

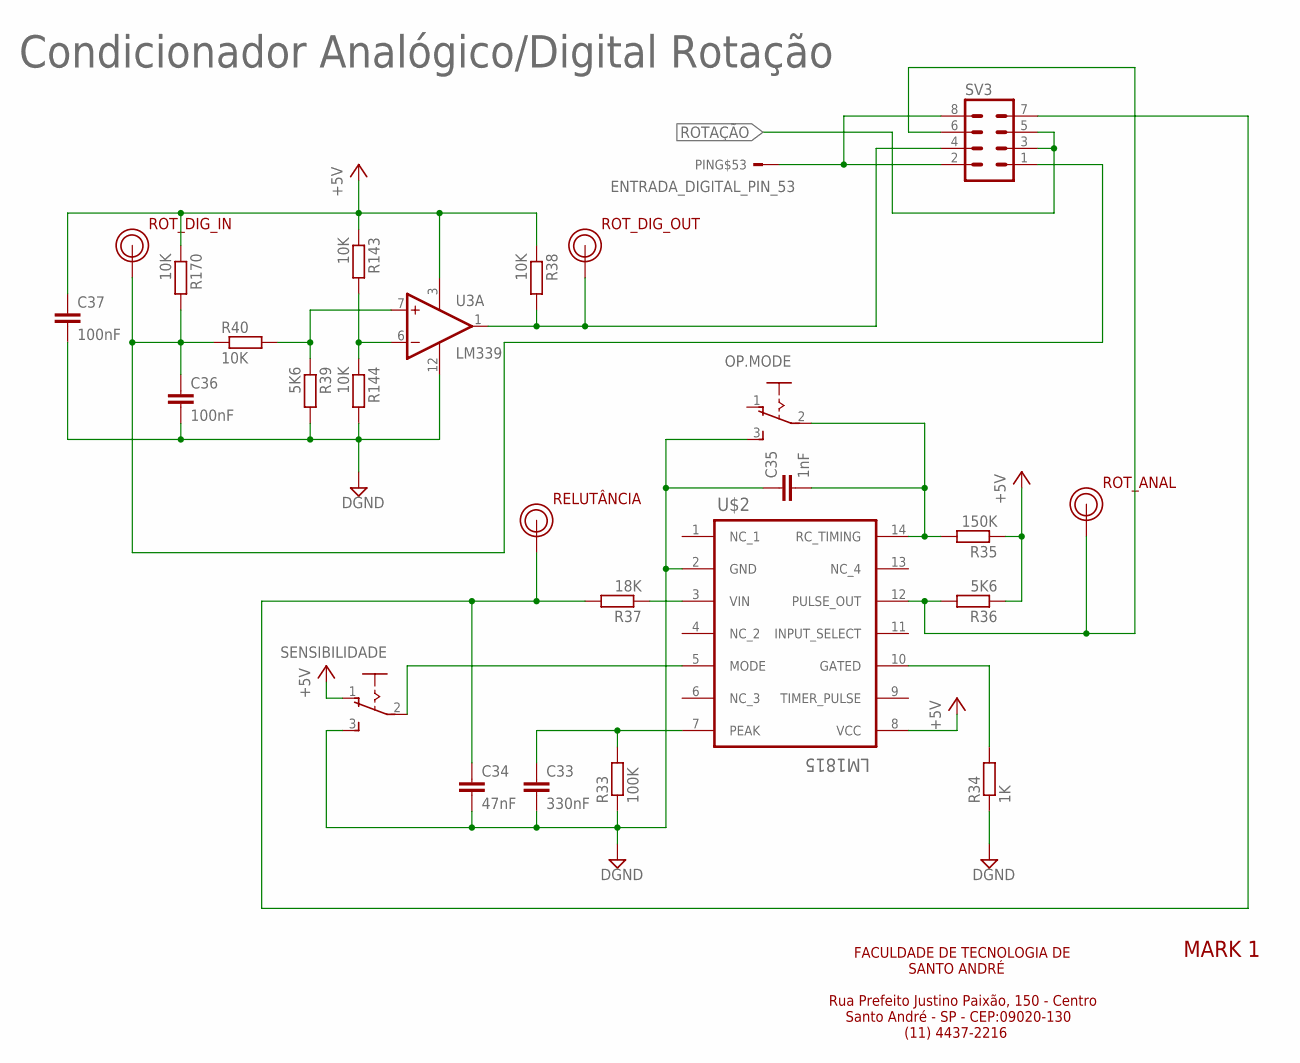
[picture p38: schematic ECU_MULT_CAR.sch, sheet 18]

Parts:
C33: 330nF; C0805
C34: 47nF; C0805
C35: 1nF; C0805
C36, C37: 100nF; C0805
OP.MODE: M251
PIN: CONCTOR_BOSCH; V23542-A1280-B300
R33: 100K; M0805
R34: 1K; M0805
R35: 150K; M0805
R36, R39: 5K6; M0805
R37: 18K; M0805
R38, R40, R143, R144, R170: 10K; M0805
RELUTÂNCIA: PINO_TORNEADO
ROT_ANAL: PINO_TORNEADO
ROT_DIG_IN: PINO_TORNEADO
ROT_DIG_OUT: PINO_TORNEADO
SENSIBILIDADE: M251
SV3: MA04-2
U3: LM339; SOIC14N
U$2: LM1815; SOICLM1815

Connections:
+5V: C37.1, R35.1, R36.1, R38.1, R143.1, R170.1, SENSIBILIDADE.1 (O), U3.3 (V+), U$2.8 (VCC); also elsewhere on the board
DGND: C33.2, C34.2, C35.1, C36.2, C37.2, OP.MODE.3 (S), R33.1, R34.1, R39.2, R144.2, SENSIBILIDADE.3 (S), U3.12 (V-), U$2.2 (GND); also elsewhere on the board
ENTRADA_DIGITAL_PIN_53: PIN.53, SV3.2, SV3.8
unnamed: C33.1, R33.2, U$2.7 (PEAK)
unnamed: R37.1, U$2.3 (VIN)
unnamed: R34.2, U$2.10 (GATED)
unnamed: C35.2, OP.MODE.2, R35.2, U$2.14 (RC_TIMING)
unnamed: R39.1, R40.2, U3.7 (+IN)
unnamed: C36.1, R40.1, R170.2, ROT_DIG_IN.1, SV3.1
unnamed: SENSIBILIDADE.2, U$2.5 (MODE)
unnamed: R143.2, R144.1, U3.6 (-IN)
RELUTÂNCIA: C34.1, R37.2, RELUTÂNCIA.1, SV3.7
ROTAÇÃO: SV3.3, SV3.5; also elsewhere on the board
ROT_ANA: R36.2, ROT_ANAL.1, SV3.6, U$2.12 (PULSE_OUT)
ROT_DIG: R38.2, ROT_DIG_OUT.1, SV3.4, U3.1 (OUT)

Notes on the sheet:
Condicionador Analógico/Digital Rotação
FACULDADE DE TECNOLOGIA DE SANTO ANDRÉ Rua Prefeito Justino Paixão, 150 - Centro Santo André - SP - CEP:09020-130 (11) 4437-2216
MARK 1
