gusmaoWilliam/FATECSO_PIC_ECU/Hardware Placa Verde PIC/layout/ECU_MULT_CAR.brd

## EAGLE design Hardware Placa Verde PIC/layout/ECU_MULT_CAR.brd (continued)

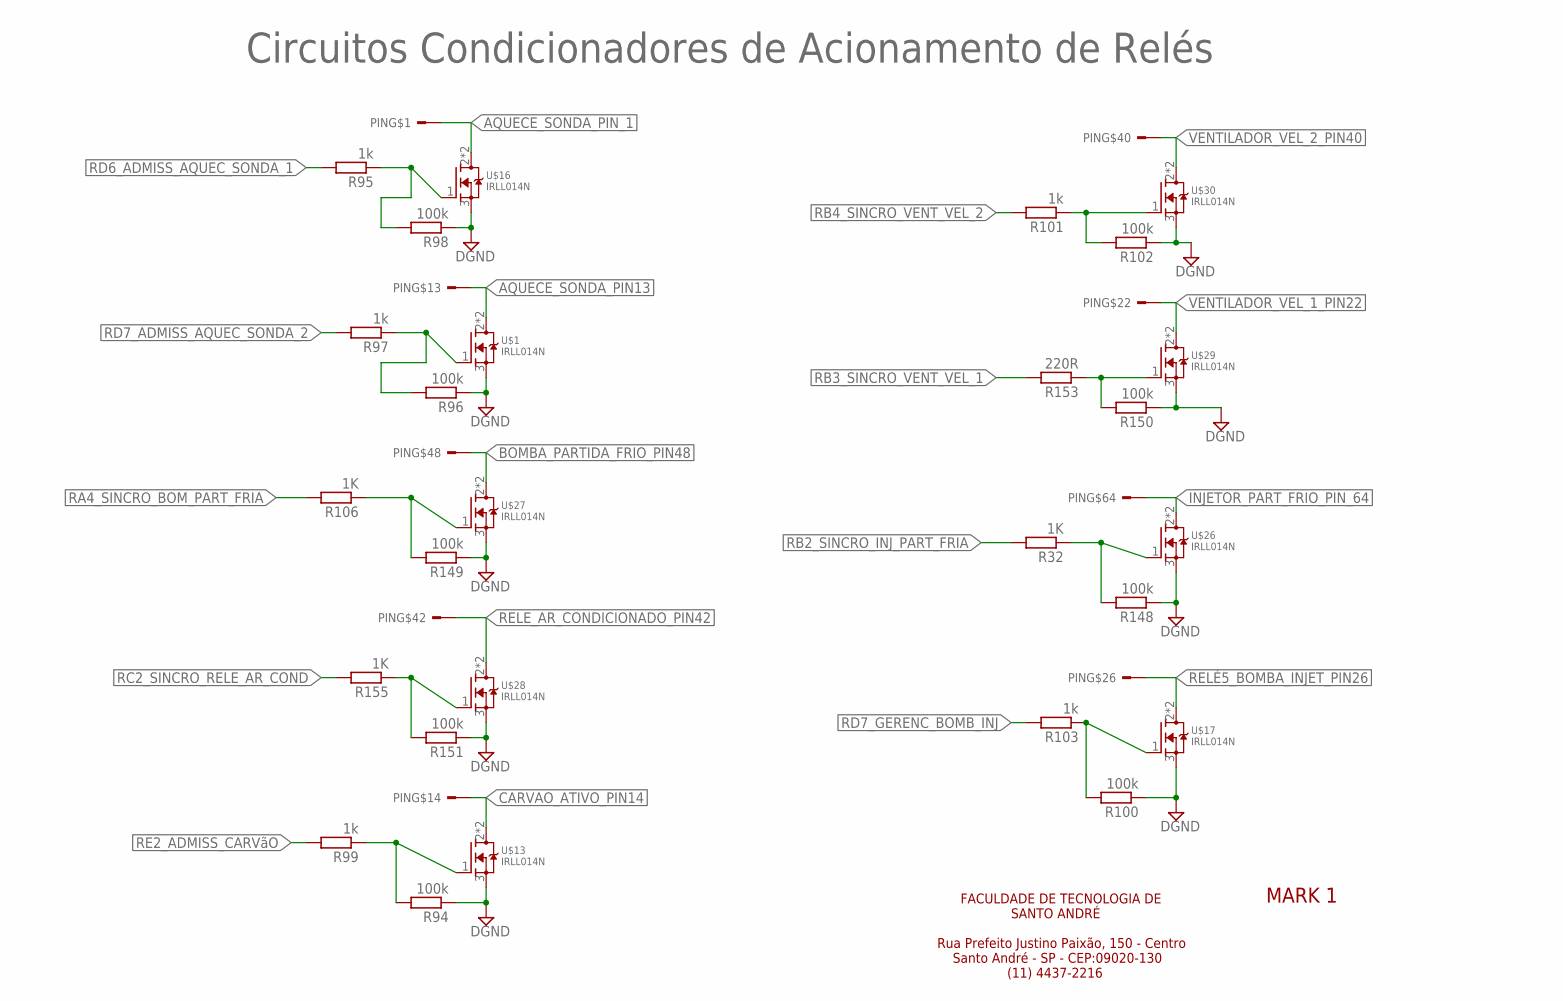
[picture p39: schematic ECU_MULT_CAR.sch, sheet 19]

Parts:
PIN: CONCTOR_BOSCH; V23542-A1280-B300
R32, R106, R155: 1K; M0805
R94, R96, R98, R100, R102, R148, R149, R150, R151: 100k; M0805
R95, R97, R99, R101, R103: 1k; M0805
R153: 220R; M0805
U$1, U$13, U$16, U$17, U$26, U$27, U$28, U$29, U$30: IRLL014N; SOT-223

Connections:
AQUECE_SONDA_PIN13: PIN.13, U$1.2 (D), U$1.4 (D)
AQUECE_SONDA_PIN_1: PIN.1, U$16.2 (D), U$16.4 (D)
BOMBA_PARTIDA_FRIO_PIN48: PIN.48, U$27.2 (D), U$27.4 (D)
CARVAO_ATIVO_PIN14: PIN.14, U$13.2 (D), U$13.4 (D)
DGND: R94.1, R96.1, R98.1, R100.1, R102.1, R148.1, R149.1, R150.1, R151.1, U$1.3 (S), U$13.3 (S), U$16.3 (S), U$17.3 (S), U$26.3 (S), U$27.3 (S), U$28.3 (S), U$29.3 (S), U$30.3 (S); also elsewhere on the board
INJETOR_PART_FRIO_PIN_64: PIN.64, U$26.2 (D), U$26.4 (D)
unnamed: R95.1, R98.2, U$16.1 (G)
unnamed: R96.2, R97.1, U$1.1 (G)
unnamed: R94.2, R99.1, U$13.1 (G)
unnamed: R100.2, R103.1, U$17.1 (G)
unnamed: R32.1, R148.2, U$26.1 (G)
unnamed: R106.1, R149.2, U$27.1 (G)
unnamed: R101.1, R102.2, U$30.1 (G)
unnamed: R150.2, R153.1, U$29.1 (G)
unnamed: R151.2, R155.1, U$28.1 (G)
RA4_SINCRO_BOM_PART_FRIA: R106.2; also elsewhere on the board
RB2_SINCRO_INJ_PART_FRIA: R32.2; also elsewhere on the board
RB3_SINCRO_VENT_VEL_1: R153.2; also elsewhere on the board
RB4_SINCRO_VENT_VEL_2: R101.2; also elsewhere on the board
RC2_SINCRO_RELE_AR_COND: R155.2; also elsewhere on the board
RD6_ADMISS_AQUEC_SONDA_1: R95.2; also elsewhere on the board
RD7_ADMISS_AQUEC_SONDA_2: R97.2; also elsewhere on the board
RD7_GERENC_BOMB_INJ: R103.2; also elsewhere on the board
RE2_ADMISS_CARVãO: R99.2; also elsewhere on the board
RELE_AR_CONDICIONADO_PIN42: PIN.42, U$28.2 (D), U$28.4 (D)
RELÉ5_BOMBA_INJET_PIN26: PIN.26, U$17.2 (D), U$17.4 (D)
VENTILADOR_VEL_1_PIN22: PIN.22, U$29.2 (D), U$29.4 (D)
VENTILADOR_VEL_2_PIN40: PIN.40, U$30.2 (D), U$30.4 (D)

Notes on the sheet:
Circuitos Condicionadores de Acionamento de Relés
FACULDADE DE TECNOLOGIA DE SANTO ANDRÉ Rua Prefeito Justino Paixão, 150 - Centro Santo André - SP - CEP:09020-130 (11) 4437-2216
MARK 1

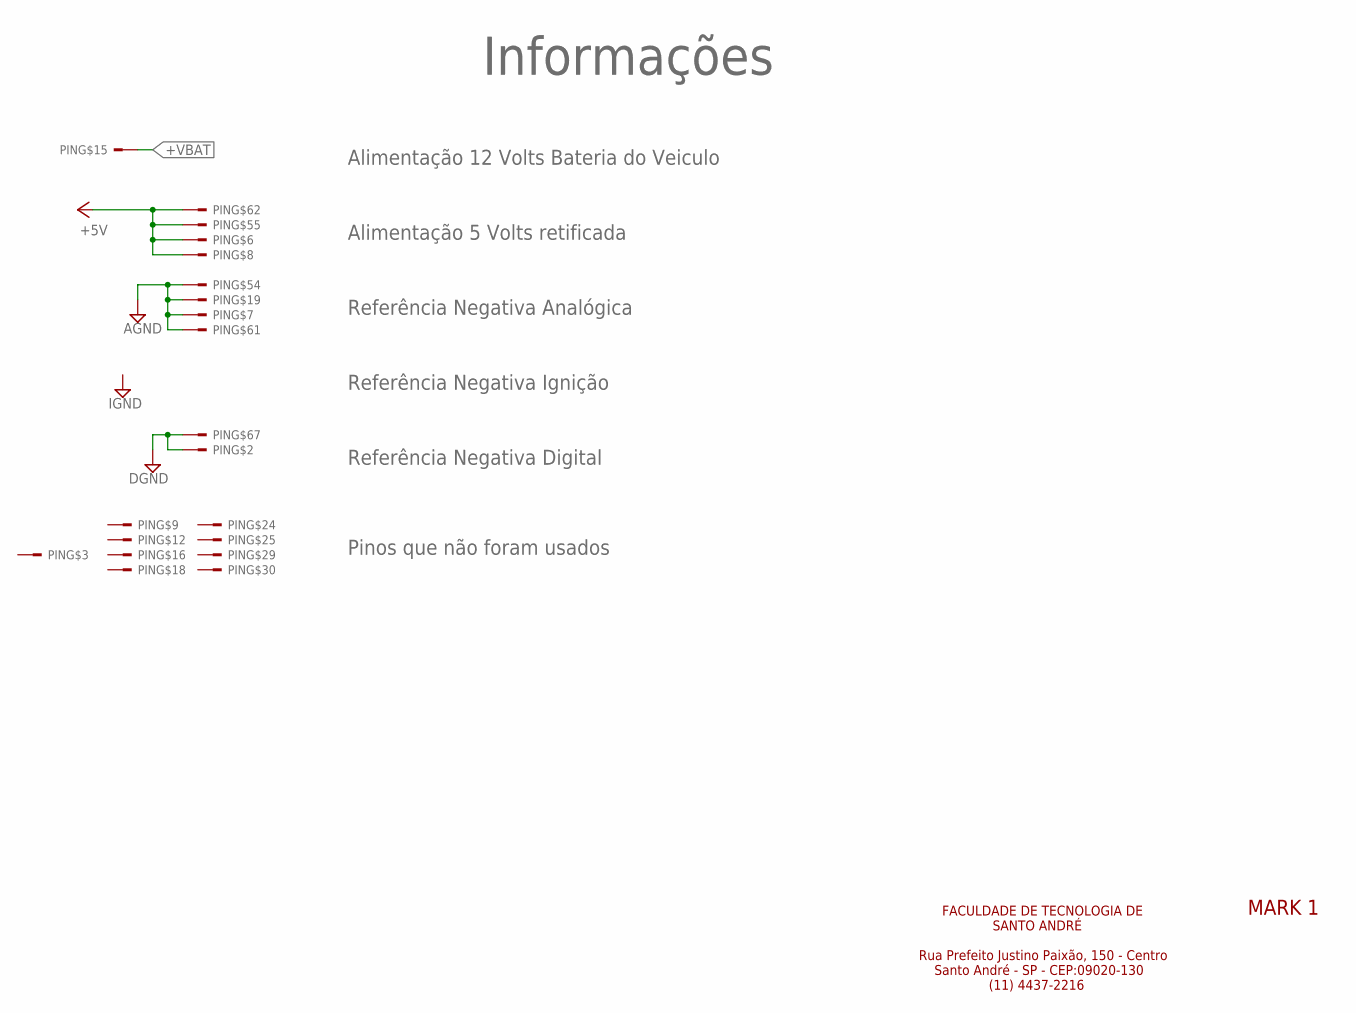
[picture p40: schematic ECU_MULT_CAR.sch, sheet 20]

Parts:
PIN: CONCTOR_BOSCH; V23542-A1280-B300

Connections:
+5V: PIN.6, PIN.8, PIN.55, PIN.62; also elsewhere on the board
+VBAT: PIN.15; also elsewhere on the board
DGND: PIN.2, PIN.67; also elsewhere on the board
GND3: PIN.7, PIN.19, PIN.54, PIN.61; also elsewhere on the board

Notes on the sheet:
Referência Negativa Analógica
Referência Negativa Ignição
Referência Negativa Digital
Pinos que não foram usados
Alimentação 12 Volts Bateria do Veiculo
Alimentação 5 Volts retificada
Informações
FACULDADE DE TECNOLOGIA DE SANTO ANDRÉ Rua Prefeito Justino Paixão, 150 - Centro Santo André - SP - CEP:09020-130 (11) 4437-2216
MARK 1

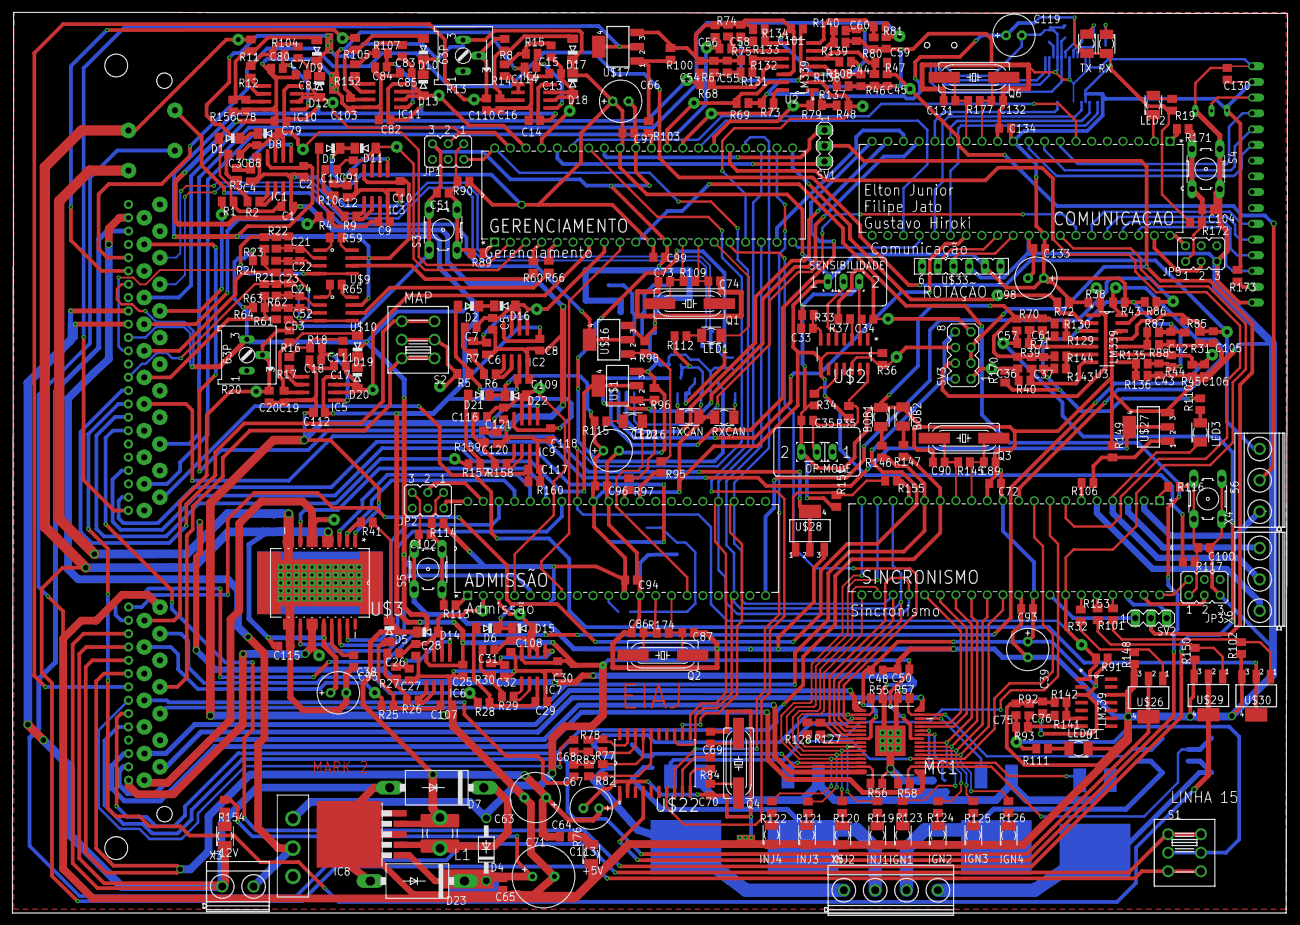
[picture p41: board ECU_MULT_CAR.brd from above]

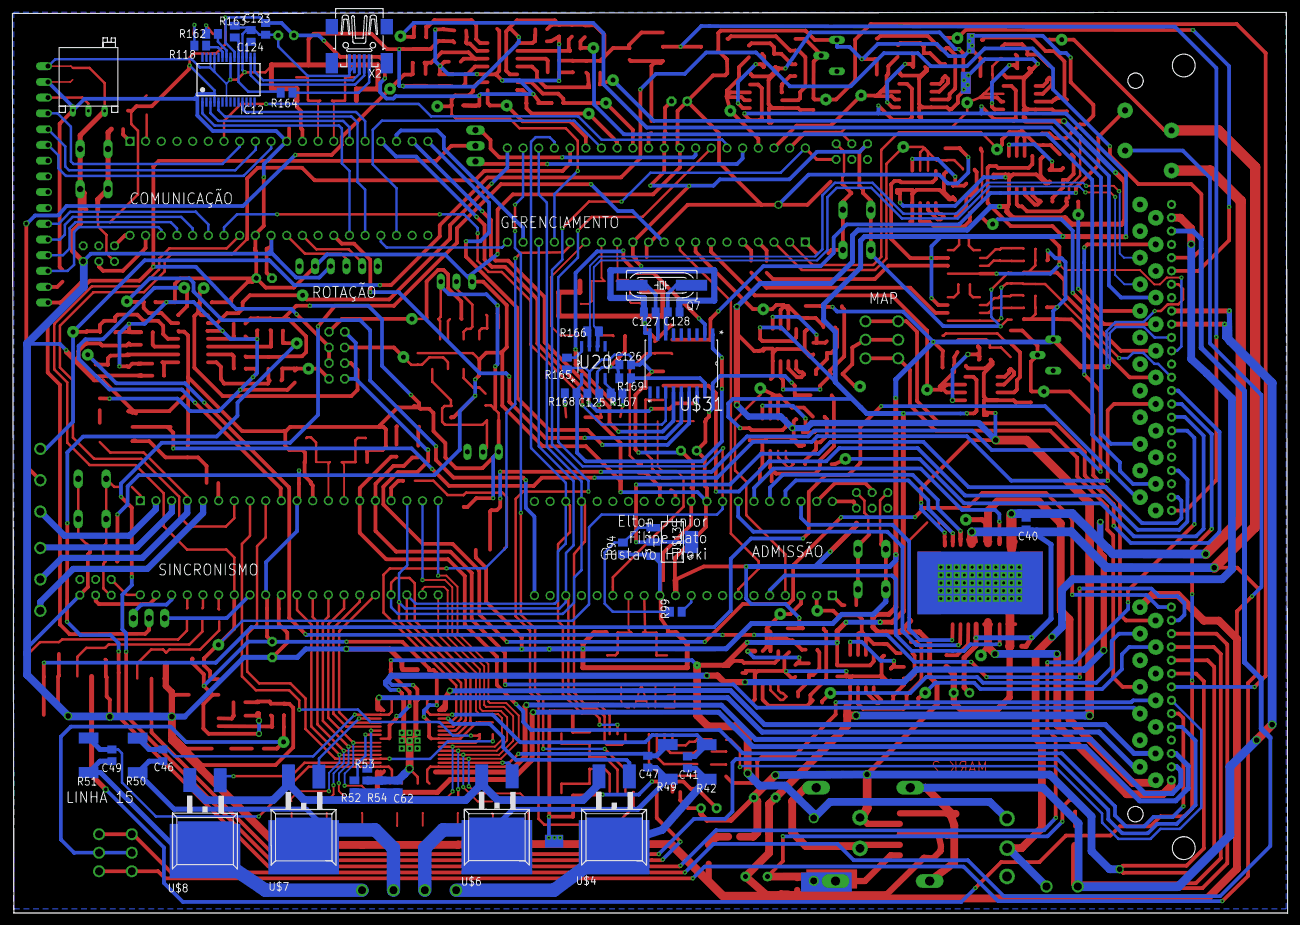
[picture p42: board ECU_MULT_CAR.brd from below]

Board: 2 copper layers, 206.6 x 145.9 mm, 466 parts (41 on the bottom side), 311 nets.

Other parts of the board:
DRILEGEND: DRILEGEND
U$14: A4L-LOC
