gusmaoWilliam/FATECSO_PIC_ECU/Software Aplicativo Calibracao e Aquisicao/GerenciamentoOnline/janelagerenciamento.cpp

#include "janelagerenciamento.h"
#include "ui_janelagerenciamento.h"


/*
 *  ARQUIVO NAO UTILIZADO
 */


JanelaGerenciamento::JanelaGerenciamento(QWidget *parent) :
    QMainWindow(parent),
    ui(new Ui::JanelaGerenciamento)
{
    ui->setupUi(this);
}

JanelaGerenciamento::~JanelaGerenciamento()
{
    delete ui;
}
